pridolfi/mateboard/doc/mateboard.png

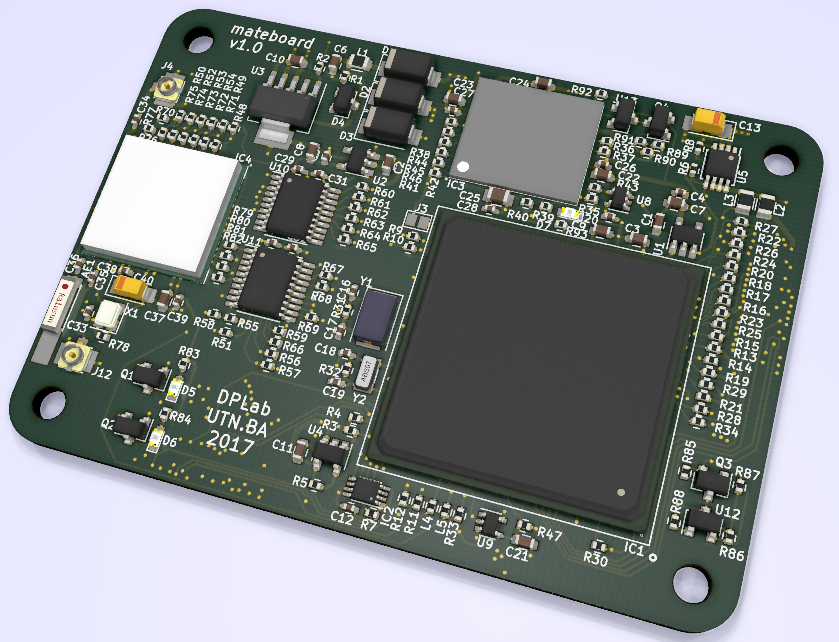
doc/mateboard.png
