pridolfi/mateboard/doc/Mate Presupuesto.ods

Item | qtty | price | shipping | Proveedor
PCB Mate | 3 | 296.00 USD | 40.00 USD | PCB Cart |  | PCB Cart | $5,880.00
Components Mate | 3 | 326.83 USD | 35.00 USD | Mouser |  | Mouser | $8,574.48
PCB Base | 3 | 90.00 USD |  | Meyer |  | Meyer | $1,575.00
Components Base | 3 | 128.14 USD |  | Mouser |  | Assembly | $1,575.00
 |  | 840.97 USD | 75.00 USD | 915.97 USD | $16,029.48
Manufacturing |  | 90.00 USD |  |  | $1,575.00
 |  |  |  |  | $17,604.48
 | 1u$s | $17.50
Averiguar
Montos tope
Facturas con empresas extranjeras ($ o U$s, shipping, etc)
Procedimiento (como pagar, que items deben figurar en la factura, etc)
