pridolfi/mateboard/doc/mateboard.xlsx

 |  |  |  |  |  |  | Board Qty: | 100
 |  |  |  |  |  |  | Total Cost: | $0.00 |  |  |  | $0.00 |  |  |  |  |  | $0.00 |  |  |  |  |  | $0.00 |  |  |  |  |  | $0.00 |  |  |  |  |  | $0.00
 |  |  |  |  |  |  | Unit Cost: | $0.00
Global Part Info |  |  |  |  |  |  |  |  | Digi-Key |  |  |  |  |  | Farnell |  |  |  |  |  | Mouser |  |  |  |  |  | Newark |  |  |  |  |  | Rs Components
Refs | Value | Desc | Footprint | Manf | Manf# | Qty | Unit$ | Ext$ | Avail | Purch | Unit$ | Ext$ | Cat# | Doc | Avail | Purch | Unit$ | Ext$ | Cat# | Doc | Avail | Purch | Unit$ | Ext$ | Cat# | Doc | Avail | Purch | Unit$ | Ext$ | Cat# | Doc | Avail | Purch | Unit$ | Ext$ | Cat# | Doc
R70 | DNP 10k |  | Resistors_SMD:R_0402 |  |  | 0 | $0.00 | $0.00
R3,R4,R58 | 1.5k |  | Resistors_SMD:R_0402 |  | RC0402FR-071K5L | 0 | $0.00 | $0.00 | 1400053 |  | $0.00 | $0.00 | 311-1.50KLRCT-ND | Link (http://www.digikey.com/product-detail/en/yageo/RC0402FR-071K5L/311-1.50KLRCT-ND/729466) |  |  | $0.00 | $0.00 | 9239251 | Link (http://it.farnell.com/yageo-phycomp/rc0402fr-071k5l/res-film-spesso-1k5-1-0-063w-0402/dp/9239251) | 288627 |  | $0.00 | $0.00 | 603-RC0402FR-071K5L | Link (http://www.mouser.com/Search/Refine.aspx?Keyword=RC0402FR-071K5L%20) |  |  | $0.00 | $0.00 | 67R9880 | Link (http://www.newark.com/yageo/rc0402fr-071k5l/res-thick-film-1k5-1-0-0625w-0402/dp/67R9880)
L4,L5 | BLM15AG102SN1D |  | Resistors_SMD:R_0402 |  | BLM15AG102SN1D | 0 | $0.00 | $0.00 | 351484 |  | $0.00 | $0.00 | 490-1007-1-ND | Link (http://www.digikey.com/product-detail/en/murata-electronics-north-america/BLM15AG102SN1D/490-1007-1-ND/584455) |  |  | $0.00 | $0.00 | 1515759RL | Link (http://it.farnell.com/murata/blm15ag102sn1d/grano-chip-1ohm-200ma-0402/dp/1515759RL) | 144423 |  | $0.00 | $0.00 | 81-BLM15AG102SN1D | Link (http://www.mouser.com/Search/Refine.aspx?Keyword=BLM15AG102SN1D%20) |  |  | $0.00 | $0.00 | 73M9022 | Link (http://www.newark.com/webapp/wcs/stores/servlet/Search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) |  |  | $0.00 | $0.00 | 724-1251 | Link (http://it.rs-online.com/web/c/?searchTerm=BLM15AG102SN1D%20)
R56,R57 | 150k |  | Resistors_SMD:R_0402 |  | RC0402FR-07150KL | 0 | $0.00 | $0.00 | 629538 |  | $0.00 | $0.00 | 311-150KLRCT-ND | Link (http://www.digikey.com/product-detail/en/yageo/RC0402FR-07150KL/311-150KLRCT-ND/729489) |  |  | $0.00 | $0.00 | 9239499 | Link (http://it.farnell.com/yageo-phycomp/rc0402fr-07150kl/res-film-spesso-150k-1-0-063w/dp/9239499) | 97865 |  | $0.00 | $0.00 | 603-RC0402FR-07150KL | Link (http://www.mouser.com/Search/Refine.aspx?Keyword=RC0402FR-07150KL%20) |  |  | $0.00 | $0.00 | 12AC2049 | Link (http://www.newark.com/yageo-phycomp/rc0402fr-07150kl/res-thick-film-150k-1-0-063w-0402/dp/12AC2049)
C38 | 1uF/6.3V |  | Capacitors_SMD:C_0402 |  | GRM155R60J105KE19D | 0 | $0.00 | $0.00 |  |  | $0.00 | $0.00 | 490-1320-1-ND | Link (http://www.digikey.com/product-detail/en/murata-electronics-north-america/GRM155R60J105KE19D/490-1320-1-ND/587919) |  |  | $0.00 | $0.00 | 1845729 | Link (http://it.farnell.com/murata/grm155r60j105ke19d/condensatore-mlcc-x5r-1uf-6-3v/dp/1845729) | 292145 |  | $0.00 | $0.00 | 81-GRM155R60J105KE19 | Link (http://www.mouser.com/Search/Refine.aspx?Keyword=GRM155R60J105KE19D%20) |  |  | $0.00 | $0.00 | 13T1188 | Link (http://www.newark.com/murata/grm155r60j105ke19d/multilayer-ceramic-capacitor-grm/dp/13T1188) | 300 |  | $0.00 | $0.00 | 723-5180 | Link (http://it.rs-online.com/web/c/?searchTerm=GRM155R60J105KE19D%20)
AE1 | 2.4GHz Antenna |  | footprints:2450AT43B100E |  | 2450AT42A100E | 0 | $0.00 | $0.00 | 41176 |  | $0.00 | $0.00 | 712-1007-1-ND | Link (http://www.digikey.com/product-detail/en/johanson-technology-inc/2450AT42A100E/712-1007-1-ND/1560836) |  |  | $0.00 | $0.00 | 2148522 | Link (http://it.farnell.com/johanson-technology/2450at42a100e/antenna-2-4ghz/dp/2148522) | 11599 |  | $0.00 | $0.00 | 609-2450AT42A100E | Link (http://www.mouser.com/Search/Refine.aspx?Keyword=2450AT42A100E%20) |  |  | $0.00 | $0.00 | 44W4471 | Link (http://www.newark.com/webapp/wcs/stores/servlet/Search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)
L3 | 0.1ohm 0805 |  | Resistors_SMD:R_0805 |  | 73L3R10J | 0 | $0.00 | $0.00 | 45331 |  | $0.00 | $0.00 | 73L3R10JCT-ND | Link (http://www.digikey.com/product-detail/en/cts-resistor-products/73L3R10J/73L3R10JCT-ND/1543529) |  |  |  |  |  |  | 17765 |  | $0.00 | $0.00 | 774-73L3R10J | Link (http://www.mouser.com/Search/Refine.aspx?Keyword=73L3R10J%20) |  |  | $0.00 | $0.00 | 12AC2373 | Link (http://www.newark.com/cgs-te-connectivity/rl73k2ar10jtd/res-thick-film-r1-5-0-125w-0805/dp/12AC2373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)
X1 | NZ2520SB-32.768KHZ-NSA3534C |  | Crystals:Crystal_SMD_2520-4pin_2.5x2.0mm |  | ASDK2-32.768KHz-LRT | 0 | $0.00 | $0.00 | 6405 |  | $0.00 | $0.00 | 535-13597-1-ND | Link (http://www.digikey.com/product-detail/en/abracon-llc/ASDK2-32.768KHZ-LR-T3/535-13597-1-ND/6167595) |  |  |  |  |  |  | 3364 |  | $0.00 | $0.00 | 815-ASDK2-32.7K-LRT | Link (http://www.mouser.com/Search/../ProductDetail/ABRACON/ASDK2-32768KHz-LRT/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) |  |  | $0.00 | $0.00 | 14T0102 | Link (http://www.newark.com/webapp/wcs/stores/servlet/Search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)
IC4 | WL1835MODGBMOCT |  | footprints:BeagleBone_Blue-GHI-IC_MOC-100(TI) |  | WL1835MODGBMOCR | 0 | $0.00 | $0.00 | 1640 |  | $0.00 | $0.00 | 296-38032-1-ND | Link (http://www.digikey.com/product-detail/en/texas-instruments/WL1835MODGBMOCR/296-38032-1-ND/4965727) |  |  | $0.00 | $0.00 | 2499535 | Link (http://it.farnell.com/webapp/wcs/stores/servlet/Search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) | 780 |  | $0.00 | $0.00 | 595-WL1835MODGBMOCR | Link (http://www.mouser.com/Search/../ProductDetail/Texas-Instruments/WL1835MODGBMOCR/) |  |  | $0.00 | $0.00 | 06X8470 | Link (http://www.newark.com/texas-instruments/wl1835modgbmocr/wilink-wi-fi-2-4ghz-mimo-bt-ble/dp/06X8470)
Q3,Q4 | MMBT2907 |  | TO_SOT_Packages_SMD:SOT-23 |  | MMBT2907ALT1G | 0 | $0.00 | $0.00 | 220280 |  | $0.00 | $0.00 | MMBT2907ALT1GOSCT-ND | Link (http://www.digikey.com/product-detail/en/on-semiconductor/MMBT2907ALT1G/MMBT2907ALT1GOSCT-ND/1139812) |  |  | $0.00 | $0.00 | 1459099 | Link (http://it.farnell.com/on-semiconductor/mmbt2907alt1g/transistor-bjt-pnp-60v-0-6a-sot/dp/1459099) | 183163 |  | $0.00 | $0.00 | 863-MMBT2907ALT1G | Link (http://www.mouser.com/Search/../ProductDetail/ON-Semiconductor/MMBT2907ALT1G/) |  |  | $0.00 | $0.00 | 88H4785 | Link (http://www.newark.com/on-semiconductor/mmbt2907alt1g/bipolar-transistor-pnp-60v-sot/dp/88H4785) | 1400 |  | $0.00 | $0.00 | 781-5231 | Link (http://it.rs-online.com/web/p/transistor-bipolari/7815231/)
R9,R10,R34,R43 | 0R |  | Resistors_SMD:R_0402 |  | RC0402JR-070RL | 0 | $0.00 | $0.00 | 15520665 |  | $0.00 | $0.00 | 311-0.0JRCT-ND | Link (http://www.digikey.com/product-detail/en/yageo/RC0402JR-070RL/311-0.0JRCT-ND/729353) |  |  | $0.00 | $0.00 | 9232516 | Link (http://it.farnell.com/yageo-phycomp/rc0402jr-070rl/res-film-spesso-0r-5-0-0625w-0402/dp/9232516) | 746488 |  | $0.00 | $0.00 | 603-RC0402JR-070RL | Link (http://www.mouser.com/Search/Refine.aspx?Keyword=RC0402JR-070RL%20) |  |  | $0.00 | $0.00 | 66R1737 | Link (http://www.newark.com/yageo/rc0402jr-070rl/res-thick-film-0r-0-0625w-0402/dp/66R1737) | 16 |  | $0.00 | $0.00 | 618-5804 | Link (http://it.rs-online.com/web/c/?searchTerm=RC0402JR-070RL%20)
U3 | TL1963A-33DCQR |  | footprints:SOT-223-6 |  | TL1963A-33DCQR | 0 | $0.00 | $0.00 | 1643 |  | $0.00 | $0.00 | 296-32342-1-ND | Link (http://www.digikey.com/product-detail/en/texas-instruments/TL1963A-33DCQT/296-32342-1-ND/3505532) |  |  |  |  |  |  | 2164 |  | $0.00 | $0.00 | 595-TL1963A-33DCQR | Link (http://www.mouser.com/Search/../ProductDetail/Texas-Instruments/TL1963A-33DCQR/) |  |  | $0.00 | $0.00 | 25R0010 | Link (http://www.newark.com/webapp/wcs/stores/servlet/Search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)
R88,R92 | 40.2k |  | Resistors_SMD:R_0402 |  | RC0402FR-0740K2L | 0 | $0.00 | $0.00 | 628943 |  | $0.00 | $0.00 | 311-40.2KLRCT-ND | Link (http://www.digikey.com/product-detail/en/yageo/RC0402FR-0740K2L/311-40.2KLRCT-ND/729554) |  |  |  |  |  |  | 51381 |  | $0.00 | $0.00 | 603-RC0402FR-0740K2L | Link (http://www.mouser.com/Search/Refine.aspx?Keyword=RC0402FR-0740K2L%20) |  |  | $0.00 | $0.00 | 66R1490 | Link (http://www.newark.com/webapp/wcs/stores/servlet/Search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)
R59,R66 | DNP 1k |  | Resistors_SMD:R_0402 |  |  | 0 | $0.00 | $0.00
R85,R89 | 499 |  | Resistors_SMD:R_0402 |  | RC0402FR-07499RL | 0 | $0.00 | $0.00 | 1290289 |  | $0.00 | $0.00 | 311-499LRCT-ND | Link (http://www.digikey.com/product-detail/en/yageo/RC0402FR-07499RL/311-499LRCT-ND/729570) |  |  | $0.00 | $0.00 | 2413645 | Link (http://it.farnell.com/yageo/rc0402fr-07499rl/res-thick-film-499r-1-0-0625w/dp/2413645) | 219450 |  | $0.00 | $0.00 | 603-RC0402FR-07499RL | Link (http://www.mouser.com/Search/Refine.aspx?Keyword=RC0402FR-07499RL%20) |  |  | $0.00 | $0.00 | 67R9943 | Link (http://www.newark.com/yageo/rc0402fr-07499rl/res-thick-film-499r-1-0-0625w/dp/67R9943)
C16-C19 | 18pF/50V |  | Capacitors_SMD:C_0402 |  | GCM1555C1H180JA16D | 0 | $0.00 | $0.00 | 181585 |  | $0.00 | $0.00 | 490-12650-1-ND | Link (http://www.digikey.com/product-detail/en/murata-electronics-north-america/GCM1555C1H180JA16D/490-12650-1-ND/5797619) |  |  |  |  |  |  | 116284 |  | $0.00 | $0.00 | 81-GCM1555C1H180JA6D | Link (http://www.mouser.com/Search/Refine.aspx?Keyword=GCM1555C1H180JA16D%20)
MH1-MH4 | Mounting hole |  | Mounting_Holes:MountingHole_3.2mm_M3 |  |  | 0 | $0.00 | $0.00
C4,C5,C12,C20,C26-C33,C39 | 100nF/6.3V |  | Capacitors_SMD:C_0402 |  | GRM155R60J104KA01D | 0 | $0.00 | $0.00 | 26123 |  | $0.00 | $0.00 | 490-6287-1-ND | Link (http://www.digikey.com/product-detail/en/murata-electronics-north-america/GRM155R60J104KA01D/490-6287-1-ND/3845484) |  |  |  |  |  |  | 280291 |  | $0.00 | $0.00 | 81-GRM155R60J104KA1D | Link (http://www.mouser.com/Search/../ProductDetail/Murata-Electronics/GRM155R60J104KA01D/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)
C13 | 220uF/6.3V |  | Capacitors_Tantalum_SMD:CP_Tantalum_Case-A_EIA-3216-18_Reflow |  | TAJD227M010RNJ | 0 | $0.00 | $0.00 | 350 |  | $0.00 | $0.00 | 478-3929-1-ND | Link (http://www.digikey.com/product-detail/en/avx-corporation/TAJD227M010RNJ/478-3929-1-ND/1126975) |  |  | $0.00 | $0.00 | 2333073 | Link (http://it.farnell.com/avx/tajd227m010rnj/condensatore-tant-220uf-10v-case/dp/2333073) | 568 |  | $0.00 | $0.00 | 581-TAJD227M010R | Link (http://www.mouser.com/Search/../ProductDetail/AVX/TAJD227M010RNJ/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) |  |  | $0.00 | $0.00 | 70K5250 | Link (http://www.newark.com/avx/tajd227m010rnj/tantalum-capacitor-220uf-10v-0/dp/70K5250)
J19 | VDD_3V3AUX |  | Measurement_Points:Measurement_Point_Round-SMD-Pad_Small |  |  | 0 | $0.00 | $0.00
R2,R78,R83,R84 | 1k |  | Resistors_SMD:R_0402 |  | RC0402FR-071KL | 0 | $0.00 | $0.00 | 17212463 |  | $0.00 | $0.00 | 311-1.00KLRCT-ND | Link (http://www.digikey.com/product-detail/en/yageo/RC0402FR-071KL/311-1.00KLRCT-ND/729460) |  |  | $0.00 | $0.00 | 9239235 | Link (http://it.farnell.com/yageo-phycomp/rc0402fr-071kl/res-film-spesso-1k-1-0-0625w-0402/dp/9239235) | 1570280 |  | $0.00 | $0.00 | 603-RC0402FR-071KL | Link (http://www.mouser.com/Search/Refine.aspx?Keyword=RC0402FR-071KL%20) |  |  | $0.00 | $0.00 | 67R9877 | Link (http://www.newark.com/yageo/rc0402fr-071kl/res-thick-film-1k-1-0-0625w-0402/dp/67R9877)
R51 | DNP 0R |  | Resistors_SMD:R_0402 |  |  | 0 | $0.00 | $0.00
J4,J12 | ANT2 |  | footprints:BeagleBone_Blue-GHI-CONNECTORS_U.FL-R-SMT-1 |  | U.FL-R-SMT-1(10) | 0 | $0.00 | $0.00 | 219950 |  | $0.00 | $0.00 | H11891CT-ND | Link (http://www.digikey.com/product-detail/en/hirose-electric-co-ltd/U.FL-R-SMT-1(10)/H11891CT-ND/2504612) |  |  | $0.00 | $0.00 | 1688077 | Link (http://it.farnell.com/webapp/wcs/stores/servlet/Search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) |  |  | $0.00 | $0.00 | 798-U.FL-R-SMT-110 | Link (http://www.mouser.com/Search/../ProductDetail/Hirose-Connector/UFL-R-SMT-110/) |  |  | $0.00 | $0.00 | 50P8856 | Link (http://www.newark.com/webapp/wcs/stores/servlet/Search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) | 1185 |  | $0.00 | $0.00 | 557-981 | Link (http://it.rs-online.com/web/c/?searchTerm=U.FL-R-SMT-1%2810%29%20)
R7,R13-R28 | 100k |  | Resistors_SMD:R_0402 |  | RC0402FR-07100KL | 0 | $0.00 | $0.00 | 19273058 |  | $0.00 | $0.00 | 311-100KLRCT-ND | Link (http://www.digikey.com/product-detail/en/yageo/RC0402FR-07100KL/311-100KLRCT-ND/729473) |  |  | $0.00 | $0.00 | 9239472 | Link (http://it.farnell.com/yageo-phycomp/rc0402fr-07100kl/res-film-spesso-100k-1-0-063w/dp/9239472) | 1715094 |  | $0.00 | $0.00 | 603-RC0402FR-07100KL | Link (http://www.mouser.com/Search/Refine.aspx?Keyword=RC0402FR-07100KL%20) |  |  | $0.00 | $0.00 | 67R9887 | Link (http://www.newark.com/yageo/rc0402fr-07100kl/res-thick-film-100k-1-0-0625w/dp/67R9887)
U12,U13 | TLVH431 |  | TO_SOT_Packages_SMD:SOT-23 |  | TLVH431IDBZR | 0 | $0.00 | $0.00 | 1496 |  | $0.00 | $0.00 | 296-17974-1-ND | Link (http://www.digikey.com/product-detail/en/texas-instruments/TLVH431IDBZR/296-17974-1-ND/765375) |  |  | $0.00 | $0.00 | 2492382 | Link (http://it.farnell.com/texas-instruments/tlvh431idbzr/voltage-ref-shunt-1-24v-18v-sot/dp/2492382) | 5853 |  | $0.00 | $0.00 | 595-TLVH431IDBZR | Link (http://www.mouser.com/Search/../ProductDetail/Texas-Instruments/TLVH431IDBZR/) |  |  | $0.00 | $0.00 | 54Y8573 | Link (http://www.newark.com/webapp/wcs/stores/servlet/Search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)
J2 | IO2 |  | footprints:DF40C-70DP-0.4V_51_ |  | DF40C-70DP-0.4V(51) | 0 | $0.00 | $0.00 | 9881 |  | $0.00 | $0.00 | H11630CT-ND | Link (http://www.digikey.com/product-detail/en/hirose-electric-co-ltd/DF40C-70DP-0.4V(51)/H11630CT-ND/1969509) |  |  |  |  |  |  | 4027 |  | $0.00 | $0.00 | 798-DF40C70DP04V51 | Link (http://www.mouser.com/Search/Refine.aspx?Keyword=DF40C-70DP-0.4V%2851%29%20)
U10,U11 | TXS0108 |  | Housings_SSOP:TSSOP-20_4.4x6.5mm_Pitch0.65mm |  | TXS0108EPWR | 0 | $0.00 | $0.00 | 78627 |  | $0.00 | $0.00 | 296-23011-1-ND | Link (http://www.digikey.com/product-detail/en/texas-instruments/TXS0108EPWR/296-23011-1-ND/1775304) |  |  | $0.00 | $0.00 | 1702548 | Link (http://it.farnell.com/texas-instruments/txs0108epwr/translator-voltage-8bit-20tssop/dp/1702548) | 14552 |  | $0.00 | $0.00 | 595-TXS0108EPWR | Link (http://www.mouser.com/Search/../ProductDetail/Texas-Instruments/TXS0108EPWR/) |  |  | $0.00 | $0.00 | 73M7866 | Link (http://www.newark.com/texas-instruments/txs0108epwr/no-of-inputs-8/dp/73M7866) | 129 |  | $0.00 | $0.00 | 709-4639 | Link (http://it.rs-online.com/web/p/traslatori-di-tensione/7094639/)
D1-D3 | STPS140A |  | Diodes_SMD:D_SMA_Standard |  | STPS140A | 0 | $0.00 | $0.00 | 13991 |  | $0.00 | $0.00 | 497-2453-1-ND | Link (http://www.digikey.com/product-detail/en/stmicroelectronics/STPS140A/497-2453-1-ND/603835) |  |  | $0.00 | $0.00 | 9907378 | Link (http://it.farnell.com/stmicroelectronics/stps140a/diodo-schottky-1a-40v/dp/9907378) | 11082 |  | $0.00 | $0.00 | 511-STPS140A | Link (http://www.mouser.com/Search/../ProductDetail/STMicroelectronics/STPS140A/) |  |  | $0.00 | $0.00 | 26M3621 | Link (http://www.newark.com/stmicroelectronics/stps140a/rectifier-diode-single-40-v-1/dp/26M3621) | 90 |  | $0.00 | $0.00 | 653-1803 | Link (http://it.rs-online.com/web/p/diodi-rettificatori-e-schottky/6531803/)
U2 | AP2112K-1.8TRG1 |  | TO_SOT_Packages_SMD:TSOT-23-5 |  | AP2112K-1.8TRG1 | 0 | $0.00 | $0.00 | 1204 |  | $0.00 | $0.00 | AP2112K-1.8TRG1DICT-ND | Link (http://www.digikey.com/product-detail/en/diodes-incorporated/AP2112K-1.8TRG1/AP2112K-1.8TRG1DICT-ND/4505256) |  |  |  |  |  |  | 2633 |  | $0.00 | $0.00 | 621-AP2112K-1.8TRG1 | Link (http://www.mouser.com/Search/Refine.aspx?Keyword=AP2112K-1.8TRG1%20) |  |  |  |  |  |  | 2650 |  | $0.00 | $0.00 | 828-3506 | Link (http://it.rs-online.com/web/p/regolatori-di-tensione-low-dropout/8283506/)
D4 | BAT54C |  | TO_SOT_Packages_SMD:SOT-23 |  | BAT54C | 0 | $0.00 | $0.00 |  |  |  |  |  |  |  |  | $0.00 | $0.00 | 2677690 | Link (http://it.farnell.com/taiwan-semiconductor/bat54c/diodo-schottky-30v-0-2a-sot-23/dp/2677690) | 136696 |  | $0.00 | $0.00 | 512-BAT54C | Link (http://www.mouser.com/Search/../ProductDetail/ON-Semiconductor-Fairchild/BAT54C/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) |  |  | $0.00 | $0.00 | 35C0398 | Link (http://www.newark.com/fairchild-semiconductor/bat54c/schottky-rectifier-common-cathode/dp/35C0398) |  |  | $0.00 | $0.00 | 436-7789 | Link (http://it.rs-online.com/web/p/diodi-rettificatori-e-schottky/4367789/)
U4 | 24LC32AT-I |  | TO_SOT_Packages_SMD:SOT-23-5 |  | 24LC32AT-I/OT | 0 | $0.00 | $0.00 | 28372 |  | $0.00 | $0.00 | 24LC32AT-I/OTCT-ND | Link (http://www.digikey.com/product-detail/en/microchip-technology/24LC32AT-I-OT/24LC32AT-I-OTCT-ND/2059983) |  |  | $0.00 | $0.00 | 1700993 | Link (http://it.farnell.com/microchip/24lc32at-i-ot/eeprom-seriale-32kbit-400khz-sot/dp/1700993) | 20352 |  | $0.00 | $0.00 | 579-24LC32AT-I/OT | Link (http://www.mouser.com/Search/Refine.aspx?Keyword=24LC32AT-I%2FOT%20) |  |  | $0.00 | $0.00 | 08P0113 | Link (http://www.newark.com/microchip/24lc32at-i-ot/serial-eeprom-32kbit-400khz-sot/dp/08P0113) |  |  |  |  | 687-8648 | Link (http://it.rs-online.com/web/p/memorie-eeprom/6878648/)
Q1,Q2 | BSS138 |  | TO_SOT_Packages_SMD:SOT-23 |  | BSS138W H6327 | 0 | $0.00 | $0.00 | 42220 |  | $0.00 | $0.00 | BSS138WH6327XTSA1CT-ND | Link (http://www.digikey.com/product-detail/en/infineon-technologies/BSS138WH6327XTSA1/BSS138WH6327XTSA1CT-ND/5410000) |  |  |  |  |  |  | 44446 |  | $0.00 | $0.00 | 726-BSS138WH6327 | Link (http://www.mouser.com/Search/../ProductDetail/Infineon-Technologies/BSS138W-H6327/)
IC1 | OSD335x |  | footprints:OSD3358-BAS-BGA400 |  | OSD3358-512M-BAS | 0 | $0.00 | $0.00 | 179 |  | $0.00 | $0.00 | 1676-1000-ND | Link (http://www.digikey.com/scripts/DkSearch/dksus.dll?WT.z_header=search_go&lang=en) |  |  |  |  |  |  | 932 |  | $0.00 | $0.00 | 415-OSD3358-512M-BAS | Link (http://www.mouser.com/Search/Refine.aspx?Keyword=OSD3358-512M-BAS%20)
J18 | VDD_CORE |  | Measurement_Points:Measurement_Point_Round-SMD-Pad_Small |  |  | 0 | $0.00 | $0.00
R11,R12 | 0 |  | Resistors_SMD:R_0402 |  | RC0402JR-070RL | 0 | $0.00 | $0.00 | 15520665 |  | $0.00 | $0.00 | 311-0.0JRCT-ND | Link (http://www.digikey.com/product-detail/en/yageo/RC0402JR-070RL/311-0.0JRCT-ND/729353) |  |  | $0.00 | $0.00 | 9232516 | Link (http://it.farnell.com/yageo-phycomp/rc0402jr-070rl/res-film-spesso-0r-5-0-0625w-0402/dp/9232516) | 746488 |  | $0.00 | $0.00 | 603-RC0402JR-070RL | Link (http://www.mouser.com/Search/Refine.aspx?Keyword=RC0402JR-070RL%20) |  |  | $0.00 | $0.00 | 66R1737 | Link (http://www.newark.com/yageo/rc0402jr-070rl/res-thick-film-0r-0-0625w-0402/dp/66R1737) | 16 |  | $0.00 | $0.00 | 618-5804 | Link (http://it.rs-online.com/web/c/?searchTerm=RC0402JR-070RL%20)
R29 | 100 |  | Resistors_SMD:R_0402 |  | RC0402FR-07100RL | 0 | $0.00 | $0.00 | 7637483 |  | $0.00 | $0.00 | 311-100LRCT-ND | Link (http://www.digikey.com/product-detail/en/yageo/RC0402FR-07100RL/311-100LRCT-ND/729474) |  |  | $0.00 | $0.00 | 9239111 | Link (http://it.farnell.com/yageo-phycomp/rc0402fr-07100rl/res-film-spesso-100r-1-0-0625w/dp/9239111) | 677189 |  | $0.00 | $0.00 | 603-RC0402FR-07100RL | Link (http://www.mouser.com/Search/Refine.aspx?Keyword=RC0402FR-07100RL%20) |  |  | $0.00 | $0.00 | 67R9888 | Link (http://www.newark.com/yageo/rc0402fr-07100rl/res-thick-film-100r-1-0-0625w/dp/67R9888)
R1,R31 | 1M |  | Resistors_SMD:R_0402 |  | RC0402FR-071ML | 0 | $0.00 | $0.00 | 4237795 |  | $0.00 | $0.00 | 311-1.00MLRCT-ND | Link (http://www.digikey.com/product-detail/en/yageo/RC0402FR-071ML/311-1.00MLRCT-ND/729462) |  |  | $0.00 | $0.00 | 9239588 | Link (http://it.farnell.com/yageo-phycomp/rc0402fr-071ml/res-film-spesso-1m-1-0-063w-0402/dp/9239588) | 276008 |  | $0.00 | $0.00 | 603-RC0402FR-071ML | Link (http://www.mouser.com/Search/Refine.aspx?Keyword=RC0402FR-071ML%20) |  |  | $0.00 | $0.00 | 67R9882 | Link (http://www.newark.com/yageo/rc0402fr-071ml/res-thick-film-1m-1-0-0625w-0402/dp/67R9882) | 3 |  | $0.00 | $0.00 | 618-6194 | Link (http://it.rs-online.com/web/c/?searchTerm=RC0402FR-071ML%20)
IC2 | SN74LVC2G241DCUR |  | Housings_SSOP:VSSOP-8_2.3x2mm_Pitch0.5mm |  | SN74LVC2G241DCUR | 0 | $0.00 | $0.00 | 84097 |  | $0.00 | $0.00 | 296-11936-1-ND | Link (http://www.digikey.com/product-detail/en/texas-instruments/SN74LVC2G241DCUR/296-11936-1-ND/389056) |  |  | $0.00 | $0.00 | 2437234 | Link (http://it.farnell.com/texas-instruments/sn74lvc2g241dcur/doppio-buffer-driver-con-uscita/dp/2437234) | 23908 |  | $0.00 | $0.00 | 595-SN74LVC2G241DCUR | Link (http://www.mouser.com/Search/../ProductDetail/Texas-Instruments/SN74LVC2G241DCUR/) |  |  | $0.00 | $0.00 | 94T5055 | Link (http://www.newark.com/texas-instruments/sn74lvc2g241dcur/non-inverting-buffer-vssop-8/dp/94T5055) | 160 |  | $0.00 | $0.00 | 809-6068 | Link (http://it.rs-online.com/web/c/?searchTerm=SN74LVC2G241DCUR%20)
C34-C36 | 10pF |  | Capacitors_SMD:C_0402 |  | GCM1555C1H100JA16D | 0 | $0.00 | $0.00 | 188590 |  | $0.00 | $0.00 | 490-10668-1-ND | Link (http://www.digikey.com/product-detail/en/murata-electronics-north-america/GCM1555C1H100JA16D/490-10668-1-ND/5251437) |  |  | $0.00 | $0.00 | 2494183 | Link (http://it.farnell.com/murata/gcm1555c1h100ja16d/cond-mlcc-c0g-np0-10pf-50v-0402/dp/2494183) |  |  | $0.00 | $0.00 | 81-GCM1555C1H100JA6D | Link (http://www.mouser.com/Search/Refine.aspx?Keyword=GCM1555C1H100JA16D%20) |  |  | $0.00 | $0.00 | 55Y9822 | Link (http://www.newark.com/webapp/wcs/stores/servlet/Search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)
R33 | 0 1% |  | Resistors_SMD:R_0402 |  | RC0402JR-070RL | 0 | $0.00 | $0.00 | 15520665 |  | $0.00 | $0.00 | 311-0.0JRCT-ND | Link (http://www.digikey.com/product-detail/en/yageo/RC0402JR-070RL/311-0.0JRCT-ND/729353) |  |  | $0.00 | $0.00 | 9232516 | Link (http://it.farnell.com/yageo-phycomp/rc0402jr-070rl/res-film-spesso-0r-5-0-0625w-0402/dp/9232516) | 746488 |  | $0.00 | $0.00 | 603-RC0402JR-070RL | Link (http://www.mouser.com/Search/Refine.aspx?Keyword=RC0402JR-070RL%20) |  |  | $0.00 | $0.00 | 66R1737 | Link (http://www.newark.com/yageo/rc0402jr-070rl/res-thick-film-0r-0-0625w-0402/dp/66R1737) | 16 |  | $0.00 | $0.00 | 618-5804 | Link (http://it.rs-online.com/web/c/?searchTerm=RC0402JR-070RL%20)
L2 | 150ohm 1000mA |  | Resistors_SMD:R_0805 |  | LI0805H151R-10 | 0 | $0.00 | $0.00 | 614929 |  | $0.00 | $0.00 | 240-2384-1-ND | Link (http://www.digikey.com/product-detail/en/laird-signal-integrity-products/LI0805H151R-10/240-2384-1-ND/806744) |  |  | $0.00 | $0.00 | 2292441 | Link (http://it.farnell.com/laird-technologies/li0805h151r-10/ferrite-bead-2012-100mhz-150r/dp/2292441) | 214966 |  | $0.00 | $0.00 | 875-LI0805H151R-10 | Link (http://www.mouser.com/Search/Refine.aspx?Keyword=LI0805H151R-10%20) |  |  | $0.00 | $0.00 | 66W8947 | Link (http://www.newark.com/webapp/wcs/stores/servlet/Search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) |  |  |  |  | 888-3204 | Link (http://it.rs-online.com/web/c/?searchTerm=LI0805H151R-10%20)
J5-J11,J13,J14 | TEST_1P |  | Measurement_Points:Measurement_Point_Round-SMD-Pad_Small |  |  | 0 | $0.00 | $0.00
U9 | 74LVC1G07DCK |  | TO_SOT_Packages_SMD:SOT-353_SC-70-5 |  | SN74LVC1G07DCKR | 0 | $0.00 | $0.00 | 64354 |  | $0.00 | $0.00 | 296-8486-1-ND | Link (http://www.digikey.com/product-detail/en/texas-instruments/SN74LVC1G07DCKR/296-8486-1-ND/377456) |  |  | $0.00 | $0.00 | 1287544 | Link (http://it.farnell.com/texas-instruments/sn74lvc1g07dckr/buffer-driver-single-smd-sc-70/dp/1287544) | 55608 |  | $0.00 | $0.00 | 595-SN74LVC1G07DCKR | Link (http://www.mouser.com/Search/../ProductDetail/Texas-Instruments/SN74LVC1G07DCKR/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) |  |  | $0.00 | $0.00 | 76C4075 | Link (http://www.newark.com/texas-instruments/sn74lvc1g07dckr/non-inverting-buffer-open-drain/dp/76C4075)
C3,C6,C9-C11,C37 | 10uF/6.3V |  | Capacitors_SMD:C_0603 |  | C1608X5R0J106M080AB | 0 | $0.00 | $0.00 | 1839534 |  | $0.00 | $0.00 | 445-4112-1-ND | Link (http://www.digikey.com/product-detail/en/tdk-corporation/C1608X5R0J106M080AB/445-4112-1-ND/1975462) |  |  | $0.00 | $0.00 | 2525086 | Link (http://it.farnell.com/tdk/c1608x5r0j106m080ab/condensatore-mlcc-x5r-10uf-6-3v/dp/2525086) | 390947 |  | $0.00 | $0.00 | 810-C1608X5R0J106M | Link (http://www.mouser.com/Search/Refine.aspx?Keyword=C1608X5R0J106M080AB%20) |  |  | $0.00 | $0.00 | 90R7666 | Link (http://www.newark.com/tdk/c1608x5r0j106m080ab/ceramic-capacitor-10uf-6-3v-x5r/dp/90R7666) | 600 |  | $0.00 | $0.00 | 741-4434 | Link (http://it.rs-online.com/web/p/condensatori-ceramici-multistrato/7414434/)
R55,R60-R65,R67-R69,R71-R77,R79-R82 | 33 |  | Resistors_SMD:R_0402 |  | RC0402JR-0733RL | 0 | $0.00 | $0.00 | 1874106 |  | $0.00 | $0.00 | 311-33JRCT-ND | Link (http://www.digikey.com/product-detail/en/yageo/RC0402JR-0733RL/311-33JRCT-ND/729414) |  |  | $0.00 | $0.00 | 9232583 | Link (http://it.farnell.com/yageo-phycomp/rc0402jr-0733rl/res-film-spesso-33r-5-0-063w-0402/dp/9232583) | 270646 |  | $0.00 | $0.00 | 603-RC0402JR-0733RL | Link (http://www.mouser.com/Search/../ProductDetail/Yageo/RC0402JR-0733RL/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) |  |  | $0.00 | $0.00 | 68R0002 | Link (http://www.newark.com/yageo/rc0402jr-0733rl/res-thick-film-33r-5-0-0625w-0402/dp/68R0002)
R86,R90 | DNP |  | Resistors_SMD:R_0402 |  |  | 0 | $0.00 | $0.00
Y1 | 24MHz |  | Crystals:Crystal_SMD_5032-2pin_5.0x3.2mm |  | 7A-24.000MAAJ-T | 0 | $0.00 | $0.00 | 102530 |  | $0.00 | $0.00 | 887-1090-1-ND | Link (http://www.digikey.com/product-detail/en/txc-corporation/7A-24.000MAAJ-T/887-1090-1-ND/2118967) |  |  | $0.00 | $0.00 | 1841952 | Link (http://it.farnell.com/txc/7a-24-000maaj-t/xtal-24-000mhz-18pf-smd-5-0x3/dp/1841952) | 14256 |  | $0.00 | $0.00 | 717-7A-24.000MAAJ-T | Link (http://www.mouser.com/Search/Refine.aspx?Keyword=7A-24.000MAAJ-T%20) |  |  | $0.00 | $0.00 | 84R5657 | Link (http://www.newark.com/txc/7a-24-000maaj-t/crystal-24mhz-18pf-5-x-3-2mm/dp/84R5657)
J16 | VDDS_DDR |  | Measurement_Points:Measurement_Point_Round-SMD-Pad_Small |  |  | 0 | $0.00 | $0.00
C1,C2,C7,C8,C21-C24 | 2.2uF/6.3V |  | Capacitors_SMD:C_0603 |  | GCM188R70J225KE22D | 0 | $0.00 | $0.00 | 201916 |  | $0.00 | $0.00 | 490-5316-1-ND | Link (http://www.digikey.com/product-detail/en/murata-electronics-north-america/GCM188R70J225KE22D/490-5316-1-ND/2039095) |  |  | $0.00 | $0.00 | 2470422 | Link (http://it.farnell.com/murata/gcm188r70j225ke22d/condensat-mlcc-x7r-2-2uf-6-3v/dp/2470422) | 670440 |  | $0.00 | $0.00 | 81-GCM188R70J225KE2D | Link (http://www.mouser.com/Search/Refine.aspx?Keyword=GCM188R70J225KE22D%20) |  |  | $0.00 | $0.00 | 45Y5161 | Link (http://www.newark.com/murata/gcm188r70j225ke22d/multilayer-ceramic-capacitor-aec/dp/45Y5161) | 150 |  | $0.00 | $0.00 | 815-1272 | Link (http://it.rs-online.com/web/c/?searchTerm=GCM188R70J225KE22D%20)
C40 | DNP 47uF |  | Capacitors_Tantalum_SMD:CP_Tantalum_Case-A_EIA-3216-18_Reflow |  |  | 0 | $0.00 | $0.00
C25 | 4.7uF/6.3V |  | Capacitors_SMD:C_0805 |  | 08056D475KAT2A | 0 | $0.00 | $0.00 | 11921 |  | $0.00 | $0.00 | 478-1416-1-ND | Link (http://www.digikey.com/product-detail/en/avx-corporation/08056D475KAT2A/478-1416-1-ND/564448) |  |  | $0.00 | $0.00 | 1833810 | Link (http://it.farnell.com/avx/08056d475kat2a/condens-mlcc-x5r-4-7uf-6-3v-0805/dp/1833810) | 17962 |  | $0.00 | $0.00 | 581-08056D475K | Link (http://www.mouser.com/Search/Refine.aspx?Keyword=08056D475KAT2A%20) |  |  | $0.00 | $0.00 | 84K8400 | Link (http://www.newark.com/avx/08056d475kat2a/ceramic-capacitor-4-7uf-6-3v-x5r/dp/84K8400) | 2750 |  | $0.00 | $0.00 | 391-173 | Link (http://it.rs-online.com/web/p/condensatori-ceramici-multistrato/0391173/)
U1 | AP2112K-3.3TRG1 |  | TO_SOT_Packages_SMD:TSOT-23-5 |  | AP2112K-3.3TRG1 | 0 | $0.00 | $0.00 | 55653 |  | $0.00 | $0.00 | AP2112K-3.3TRG1DICT-ND | Link (http://www.digikey.com/product-detail/en/diodes-incorporated/AP2112K-3.3TRG1/AP2112K-3.3TRG1DICT-ND/4505257) |  |  |  |  |  |  | 20110 |  | $0.00 | $0.00 | 621-AP2112K-3.3TRG1 | Link (http://www.mouser.com/Search/Refine.aspx?Keyword=AP2112K-3.3TRG1%20) |  |  |  |  |  |  | 8400 |  | $0.00 | $0.00 | 828-3509 | Link (http://it.rs-online.com/web/p/regolatori-di-tensione-low-dropout/8283509/)
U8 | SN74LVC1G06DCK |  | TO_SOT_Packages_SMD:SOT-353_SC-70-5 |  | SN74LVC1G06DCKR | 0 | $0.00 | $0.00 | 24402 |  | $0.00 | $0.00 | 296-8484-1-ND | Link (http://www.digikey.com/product-detail/en/texas-instruments/SN74LVC1G06DCKR/296-8484-1-ND/377453) |  |  | $0.00 | $0.00 | 2437123 | Link (http://it.farnell.com/texas-instruments/sn74lvc1g06dckr/invertitore-c-open-drain-singolo/dp/2437123) | 11842 |  | $0.00 | $0.00 | 595-SN74LVC1G06DCKR | Link (http://www.mouser.com/Search/../ProductDetail/Texas-Instruments/SN74LVC1G06DCKR/) |  |  | $0.00 | $0.00 | 76C4074 | Link (http://www.newark.com/texas-instruments/sn74lvc1g06dckr/logic-single-inverter-buff-driver/dp/76C4074) |  |  |  |  | 662-8691 | Link (http://it.rs-online.com/web/p/driver-di-linea-e-buffer/6628691/)
D5-D7 | LTST-C191TBKT |  | LEDs:LED_0603 |  | LTST-C191TBKT-5A | 0 | $0.00 | $0.00 |  |  | $0.00 | $0.00 | LTST-C191TBKT-5A-ND | Link (http://www.digikey.com/scripts/DkSearch/dksus.dll?WT.z_header=search_go&lang=en) |  |  |  |  |  |  | 1519 |  | $0.00 | $0.00 | 859-LTST-C191TBKT-5A | Link (http://www.mouser.com/Search/Refine.aspx?Keyword=LTST-C191TBKT-5A%20)
IC3 | NAND_4GB |  | footprints:BeagleBone_Blue-GHI-IC_MICRON_EMMC_153_MODIFICADO |  | SDIN8DE2-4G-I | 0 | $0.00 | $0.00 |  |  |  |  |  |  |  |  |  |  |  |  |  |  | $0.00 | $0.00 | 467-SDIN8DE2-4G-I | Link (http://www.mouser.com/Search/Refine.aspx?Keyword=SDIN8DE2-4G-I%20)
Y2 | 32.768kHz |  | Crystals:Crystal_SMD_3215-2pin_3.2x1.5mm |  | ABS07-32.768KHZ-7-T | 0 | $0.00 | $0.00 | 81815 |  | $0.00 | $0.00 | 535-9543-1-ND | Link (http://www.digikey.com/product-detail/en/abracon-llc/ABS07-32.768KHZ-7-T/535-9543-1-ND/1237010) |  |  | $0.00 | $0.00 | 1838935 | Link (http://it.farnell.com/abracon/abs07-32-768khz-7-t/cristallo-32-768khz-7pf-smd/dp/1838935) | 45306 |  | $0.00 | $0.00 | 815-ABS07-32.768K7T | Link (http://www.mouser.com/Search/Refine.aspx?Keyword=ABS07-32.768KHZ-7-T%20) |  |  | $0.00 | $0.00 | 14N8750 | Link (http://www.newark.com/abracon/abs07-32-768khz-7-t/crystal-32-768khz-7pf-3-2-x-1/dp/14N8750)
L1 | BLM21AG221SN1D |  | Resistors_SMD:R_0805 |  | BLM21AG221SN1D | 0 | $0.00 | $0.00 | 9912 |  | $0.00 | $0.00 | 490-9704-1-ND | Link (http://www.digikey.com/product-detail/en/murata-electronics-north-america/BLM21AG221SN1D/490-9704-1-ND/4934847) |  |  | $0.00 | $0.00 | 1515619 | Link (http://it.farnell.com/murata/blm21ag221sn1d/grano-chip-0-13ohm-800ma-0805/dp/1515619) | 5288 |  | $0.00 | $0.00 | 81-BLM21AG221SN1D | Link (http://www.mouser.com/Search/Refine.aspx?Keyword=BLM21AG221SN1D%20) |  |  | $0.00 | $0.00 | 73M9130 | Link (http://www.newark.com/webapp/wcs/stores/servlet/Search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) | 275 |  | $0.00 | $0.00 | 724-1488 | Link (http://it.rs-online.com/web/c/?searchTerm=BLM21AG221SN1D%20)
R93 | 4.75k |  | Resistors_SMD:R_0402 |  | RC0402FR-074K75L | 0 | $0.00 | $0.00 | 1197803 |  | $0.00 | $0.00 | 311-4.75KLCT-ND | Link (http://www.digikey.com/product-detail/en/yageo/RC0402FR-074K75L/311-4.75KLCT-ND/2827885) |  |  | $0.00 | $0.00 | 1799212 | Link (http://it.farnell.com/webapp/wcs/stores/servlet/Search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) | 4576 |  | $0.00 | $0.00 | 603-RC0402FR-074K75L | Link (http://www.mouser.com/Search/../ProductDetail/Yageo/RC0402FR-074K75L/) |  |  | $0.00 | $0.00 | 67R9934 | Link (http://www.newark.com/webapp/wcs/stores/servlet/Search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)
U5 | TPS2065CDGN |  | Housings_SSOP:MSOP-8-1EP_3x3mm_Pitch0.65mm |  | TPS2065CDGNR | 0 | $0.00 | $0.00 | 2919 |  | $0.00 | $0.00 | 296-29508-5-ND | Link (http://www.digikey.com/product-detail/en/texas-instruments/TPS2065CDGN/296-29508-5-ND/2751271) |  |  |  |  |  |  | 2362 |  | $0.00 | $0.00 | 595-TPS2065CDGNR | Link (http://www.mouser.com/Search/../ProductDetail/Texas-Instruments/TPS2065CDGNR/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) |  |  | $0.00 | $0.00 | 61T6040 | Link (http://www.newark.com/texas-instruments/tps2065cdgnr/current-limited-power-distribution/dp/61T6040)
R30 | 10k 1% |  | Resistors_SMD:R_0402 |  | RC0402FR-0710KL | 0 | $0.00 | $0.00 | 17165201 |  | $0.00 | $0.00 | 311-10.0KLRCT-ND | Link (http://www.digikey.com/product-detail/en/yageo/RC0402FR-0710KL/311-10.0KLRCT-ND/729470) |  |  | $0.00 | $0.00 | 2363463 | Link (http://it.farnell.com/yageo/rc0402fr-0710kl/res-thick-film-10k-1-0-0625w-0402/dp/2363463) | 2145434 |  | $0.00 | $0.00 | 603-RC0402FR-0710KL | Link (http://www.mouser.com/Search/Refine.aspx?Keyword=RC0402FR-0710KL%20) |  |  | $0.00 | $0.00 | 67R9884 | Link (http://www.newark.com/yageo/rc0402fr-0710kl/res-thick-film-10k-1-0-0625w-0402/dp/67R9884)
J15 | VDDS_PLL |  | Measurement_Points:Measurement_Point_Round-SMD-Pad_Small |  |  | 0 | $0.00 | $0.00
J17 | VDD_MPU |  | Measurement_Points:Measurement_Point_Round-SMD-Pad_Small |  |  | 0 | $0.00 | $0.00
J3 | GS2 |  | Connectors:GS2 |  |  | 0 | $0.00 | $0.00
R5,R6,R8,R35-R42,R44-R50,R52-R54,R87,R91 | 10k |  | Resistors_SMD:R_0402 |  | RC0402FR-0710KL | 0 | $0.00 | $0.00 | 17165201 |  | $0.00 | $0.00 | 311-10.0KLRCT-ND | Link (http://www.digikey.com/product-detail/en/yageo/RC0402FR-0710KL/311-10.0KLRCT-ND/729470) |  |  | $0.00 | $0.00 | 2363463 | Link (http://it.farnell.com/yageo/rc0402fr-0710kl/res-thick-film-10k-1-0-0625w-0402/dp/2363463) | 2145434 |  | $0.00 | $0.00 | 603-RC0402FR-0710KL | Link (http://www.mouser.com/Search/Refine.aspx?Keyword=RC0402FR-0710KL%20) |  |  | $0.00 | $0.00 | 67R9884 | Link (http://www.newark.com/yageo/rc0402fr-0710kl/res-thick-film-10k-1-0-0625w-0402/dp/67R9884)
J20 | VDD_RTC |  | Measurement_Points:Measurement_Point_Round-SMD-Pad_Small |  |  | 0 | $0.00 | $0.00
J1 | IO1 |  | footprints:DF40C-70DP-0.4V_51_ |  | DF40C-70DP-0.4V(51) | 0 | $0.00 | $0.00 | 9881 |  | $0.00 | $0.00 | H11630CT-ND | Link (http://www.digikey.com/product-detail/en/hirose-electric-co-ltd/DF40C-70DP-0.4V(51)/H11630CT-ND/1969509) |  |  |  |  |  |  | 4027 |  | $0.00 | $0.00 | 798-DF40C70DP04V51 | Link (http://www.mouser.com/Search/Refine.aspx?Keyword=DF40C-70DP-0.4V%2851%29%20)
R32 | DNP 1M |  | Resistors_SMD:R_0402 |  |  | 0 | $0.00 | $0.00
 |  |  |  |  |  |  |  |  |  | 0 | 0 | 0 |  |  |  | 0 | 0 | 0 |  |  |  | 0 | 0 | 0 |  |  |  | 0 | 0 | 0 |  |  |  | 0 | 0 | 0
 |  |  |  |  |  |  |  |  |  | 0 | 0 | 0 |  |  |  | 0 | 0 | 0 |  |  |  | 0 | 0 | 0 |  |  |  | 0 | 0 | 0 |  |  |  | 0 | 0 | 0
 |  |  |  |  |  |  |  |  |  | 0 | 0 | 0 |  |  |  | 0 | 0 | 0 |  |  |  | 0 | 0 | 0 |  |  |  | 0 | 0 | 0 |  |  |  | 0 | 0 | 0
 |  |  |  |  |  |  |  |  |  | 0 | 0 | 0 |  |  |  | 0 | 0 | 0 |  |  |  | 0 | 0 | 0 |  |  |  | 0 | 0 | 0 |  |  |  | 0 | 0 | 0
 |  |  |  |  |  |  |  |  |  | 0 | 0 | 0 |  |  |  | 0 | 0 | 0 |  |  |  | 0 | 0 | 0 |  |  |  | 0 | 0 | 0 |  |  |  | 0 | 0 | 0
 |  |  |  |  |  |  |  |  |  | 0 | 0 | 0 |  |  |  | 0 | 0 | 0 |  |  |  | 0 | 0 | 0 |  |  |  | 0 | 0 | 0 |  |  |  | 0 | 0 | 0
 |  |  |  |  |  |  |  |  |  | 0 | 0 | 0 |  |  |  | 0 | 0 | 0 |  |  |  | 0 | 0 | 0 |  |  |  | 0 | 0 | 0 |  |  |  | 0 | 0 | 0
 |  |  |  |  |  |  |  |  |  | 0 | 0 | 0 |  |  |  | 0 | 0 | 0 |  |  |  | 0 | 0 | 0 |  |  |  | 0 | 0 | 0 |  |  |  | 0 | 0 | 0
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
 |  |  |  |  |  |  |  |  |  | 0 | 0 | 0 |  |  |  | 0 | 0 | 0 |  |  |  | 0 | 0 | 0 |  |  |  | 0 | 0 | 0 |  |  |  | 0 | 0 | 0
 |  |  |  |  |  |  |  |  |  | 0 | 0 | 0 |  |  |  | 0 | 0 | 0 |  |  |  | 0 | 0 | 0 |  |  |  | 0 | 0 | 0 |  |  |  | 0 | 0 | 0
