pridolfi/mateboard/3dmodel/User Library-AN9520.STEP

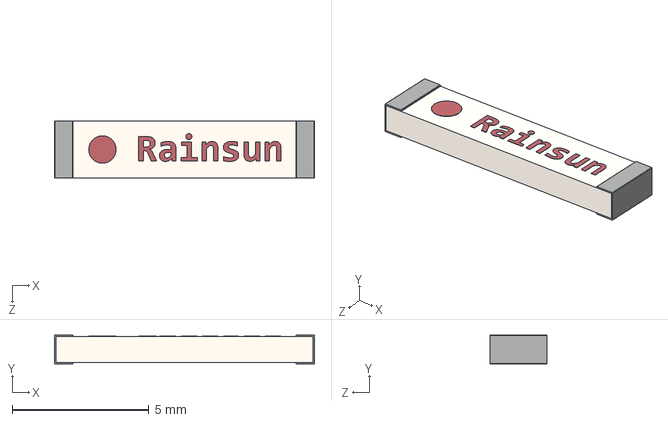
[picture p2: CAD file, 2017-06-29]
3dmodel/User Library-AN9520.STEP
9.50 x 1.05 x 2.10 mm
