pridolfi/mateboard/3dmodel/ABS07.STEP

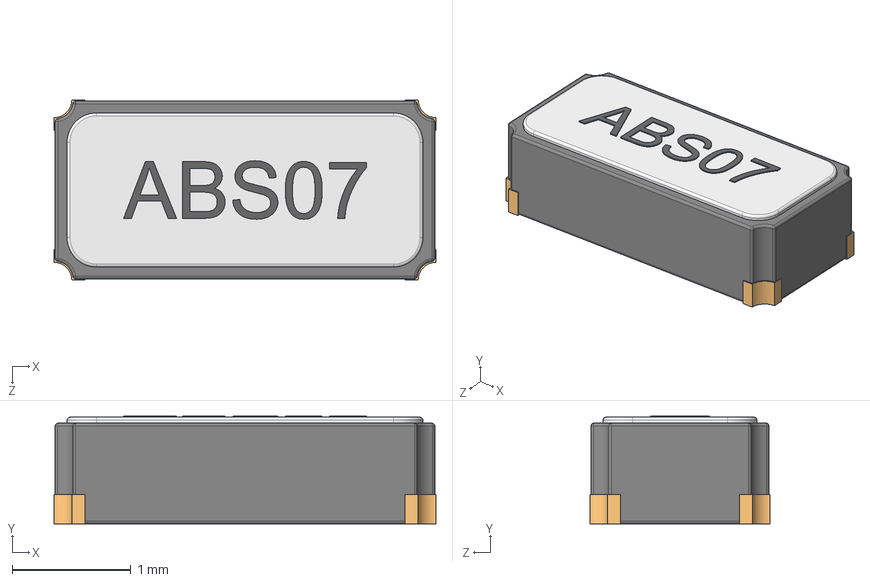
[picture p3: CAD file, 2017-06-29]
3dmodel/ABS07.STEP
3.22 x 0.91 x 1.52 mm
User Library-ABS07_ABS07 Body_2
User Library-ABS07_ABS07 Body2_2
User Library-ABS07_ABS07 Beschriftung_2
User Library-ABS07_ABS07 Pads_2
