pridolfi/mateboard/3dmodel/WL18xx.STEP

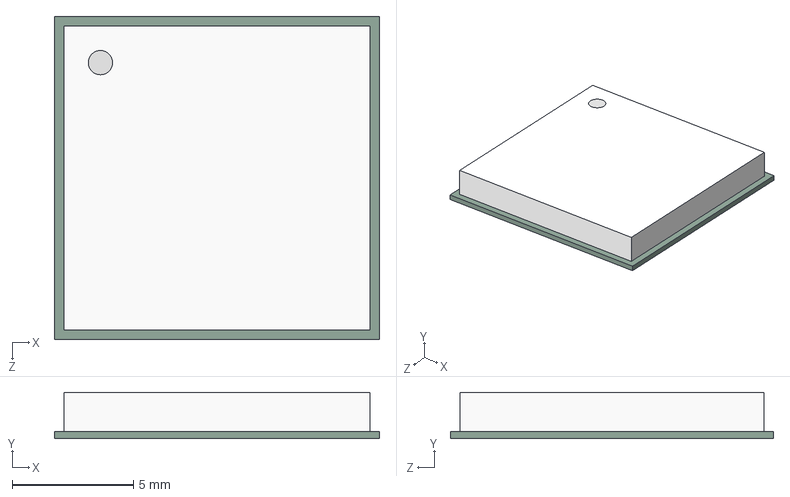
[picture p4: CAD file, 2017-06-29]
3dmodel/WL18xx.STEP
13.4 x 1.90 x 13.3 mm
