pridolfi/mateboard/3dmodel/User Library-153BallWFBGA.STEP

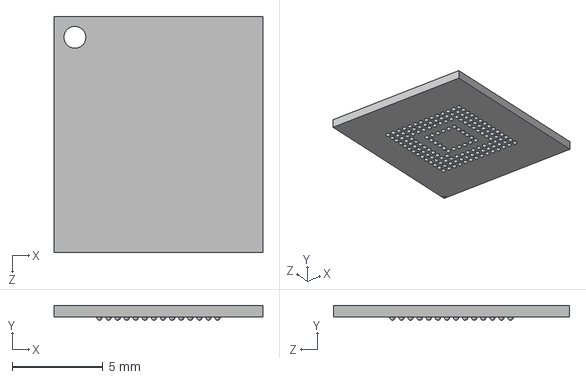
[picture p5: CAD file, 2017-06-29]
3dmodel/User Library-153BallWFBGA.STEP
11.5 x 0.802 x 13.0 mm
