pridolfi/mateboard/3dmodel/SOT-223_5MC.stp

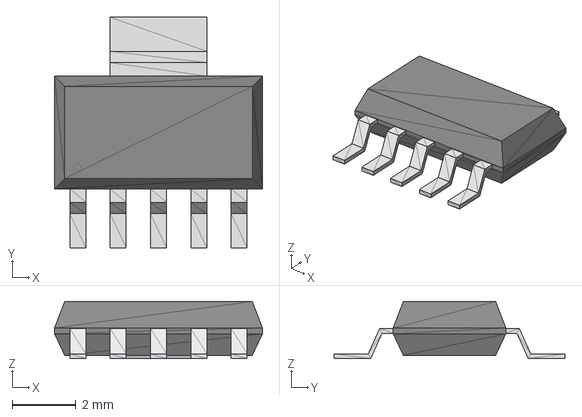
[picture p6: CAD file, 2017-06-21]
3dmodel/SOT-223_5MC.stp
6.55 x 7.26 x 1.80 mm
