pridolfi/mateboard/3dmodel/DF40C-70DP.stp

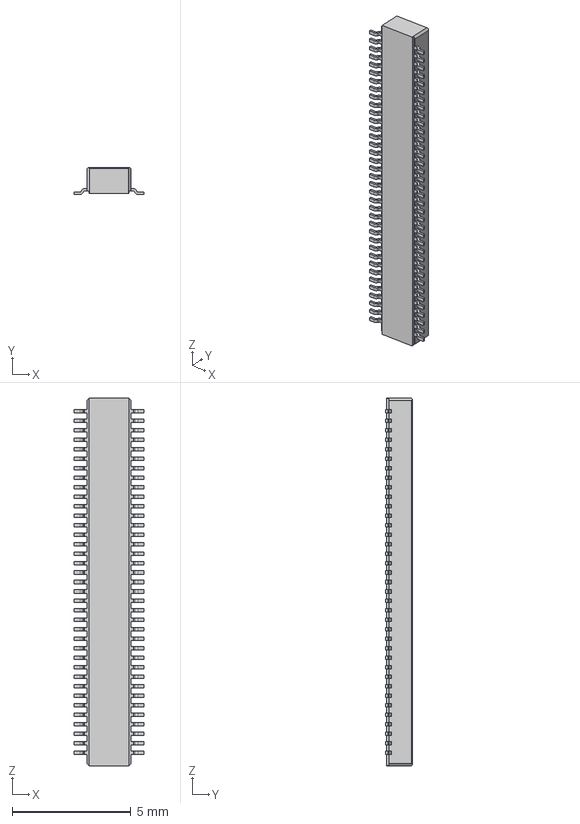
[picture p7: CAD file, 2017-06-21]
3dmodel/DF40C-70DP.stp
2.97 x 1.14 x 15.5 mm
