pridolfi/mateboard/3dmodel/U.FL-R-SMT-1.stp

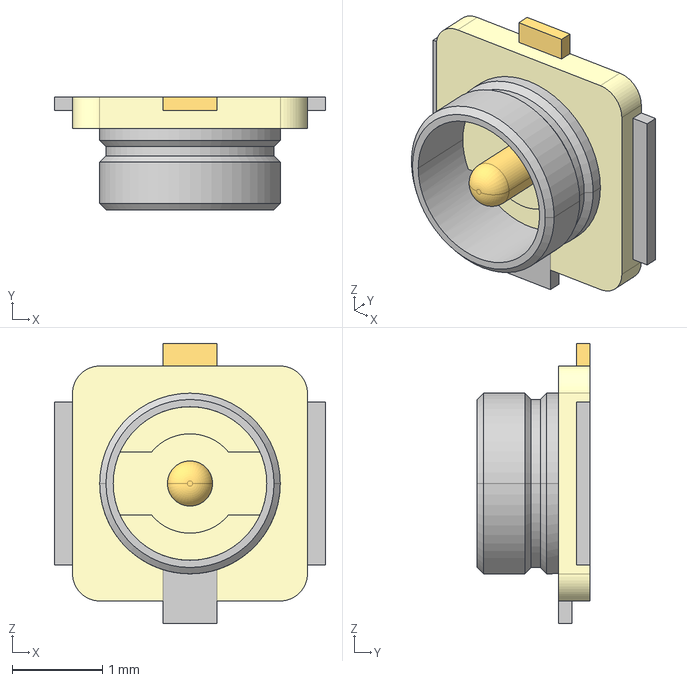
[picture p8: CAD file, 2017-06-21]
3dmodel/U.FL-R-SMT-1.stp
3.00 x 1.25 x 3.10 mm
