pridolfi/mateboard/doc/mateboard.pdf

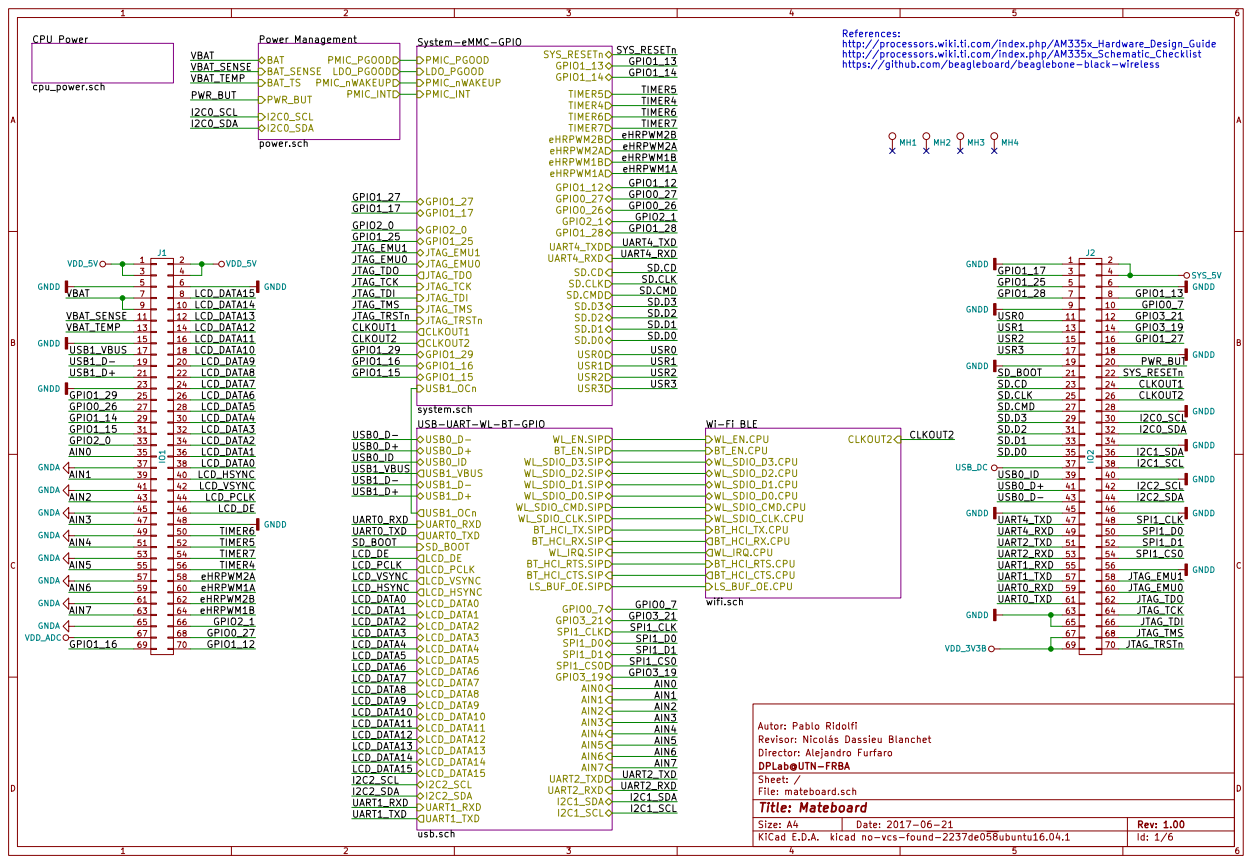
[picture p9: page 1]

https://github.com/beagleboard/beaglebone-black-wireless VBAT VBAT_SENSE

http://processors.wiki.ti.com/index.php/AM335x_Schematic_Checklist

LCD_DATA5
LCD_DATA6
LCD_DATA7
LCD_DATA8
LCD_DATA9
LCD_DATA10
LCD_DATA11
LCD_DATA12
LCD_DATA13
LCD_DATA14
LCD_DATA15

Director: Alejandro Furfaro Revisor: Nicolás Dassieu Blanchet Autor: Pablo Ridolfi

File: mateboard.sch Sheet: / DPLab@UTN-FRBA

UART2_TXD

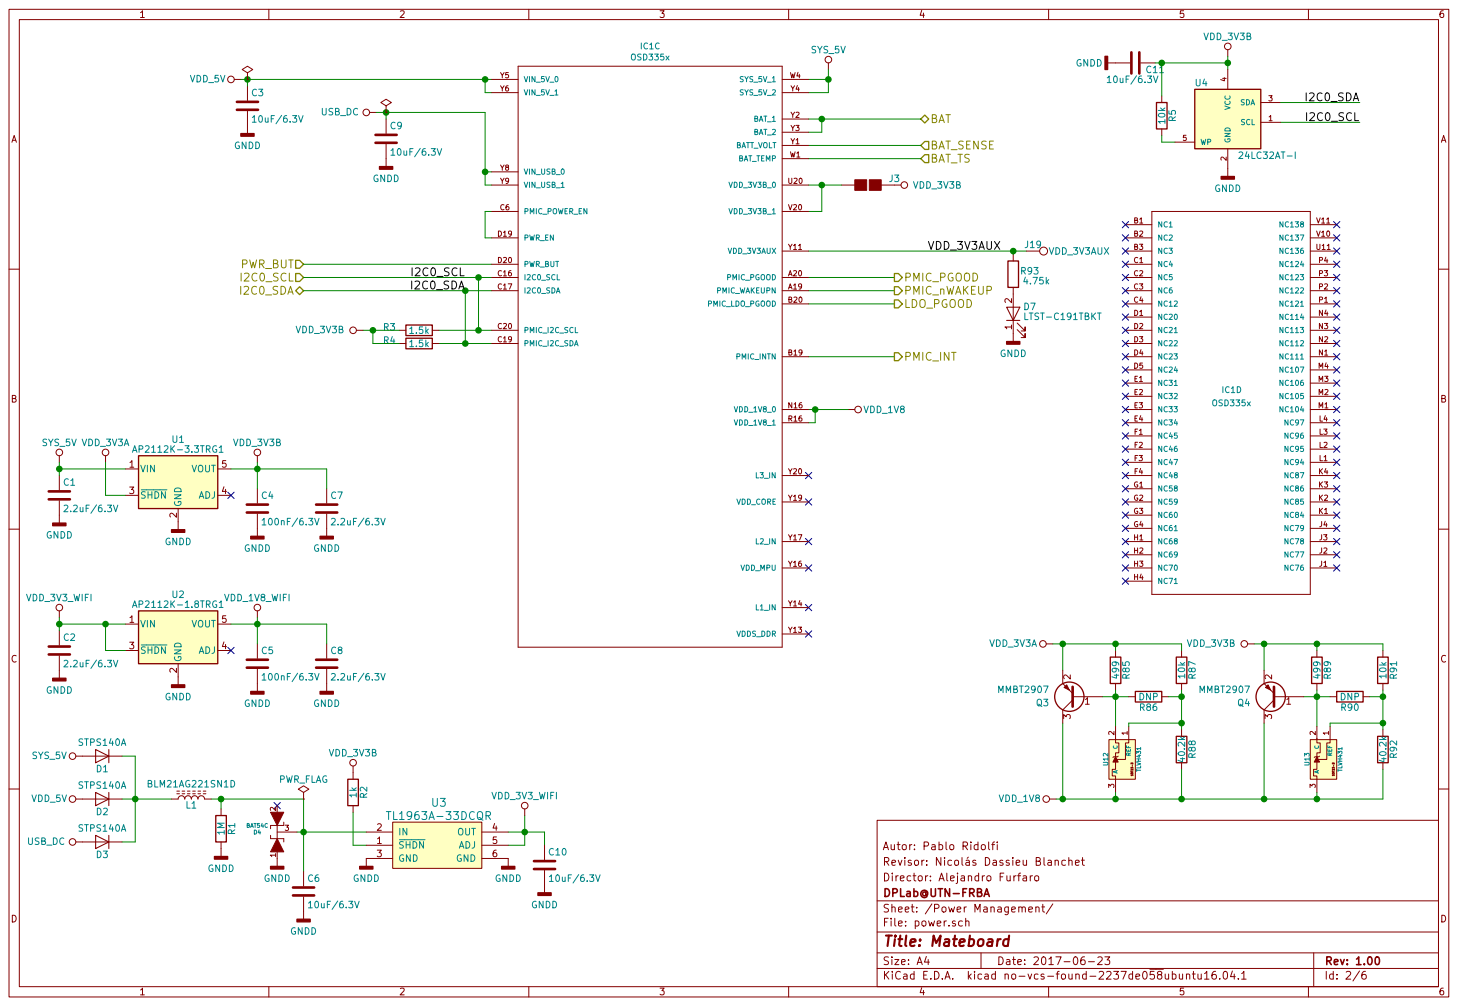
[picture p10: page 2]

I2C0_SCL

I2C0_SDA C17

Director: Alejandro Furfaro Revisor: Nicolás Dassieu Blanchet Autor: Pablo Ridolfi

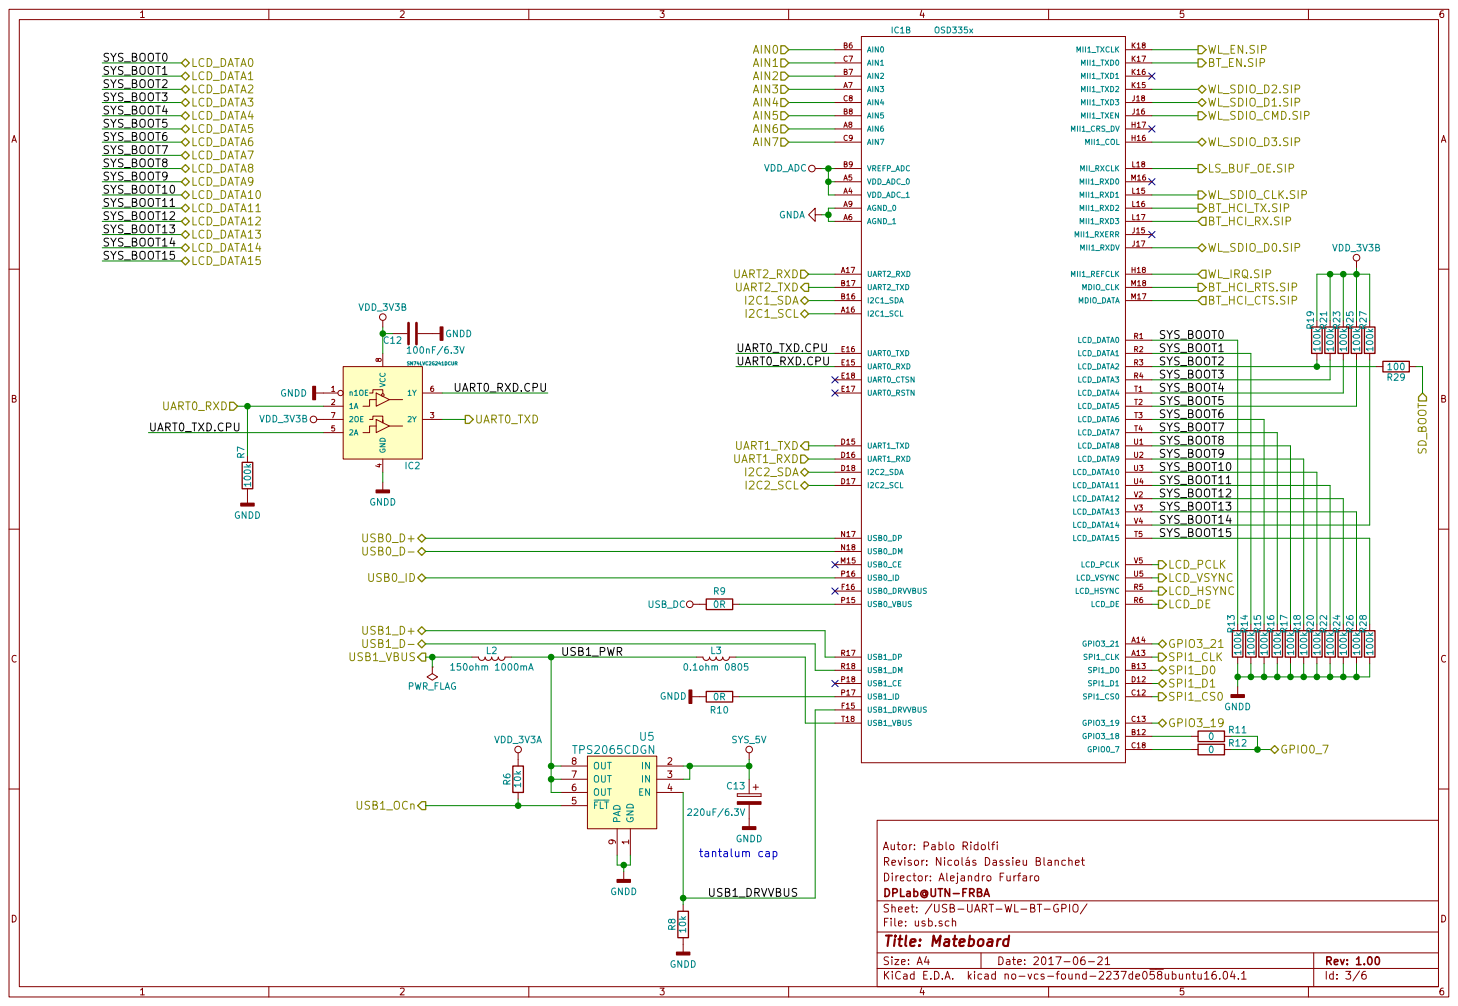
[picture p11: page 3]

SYS_BOOT4
SYS_BOOT5

SYS_BOOT7
SYS_BOOT8
SYS_BOOT9
SYS_BOOT10
SYS_BOOT11
SYS_BOOT12
SYS_BOOT13
SYS_BOOT14

Director: Alejandro Furfaro Revisor: Nicolás Dassieu Blanchet Autor: Pablo Ridolfi USB0_D+
USB0_D-

File: usb.sch Sheet: /USB-UART-WL-BT-GPIO/ DPLab@UTN-FRBA

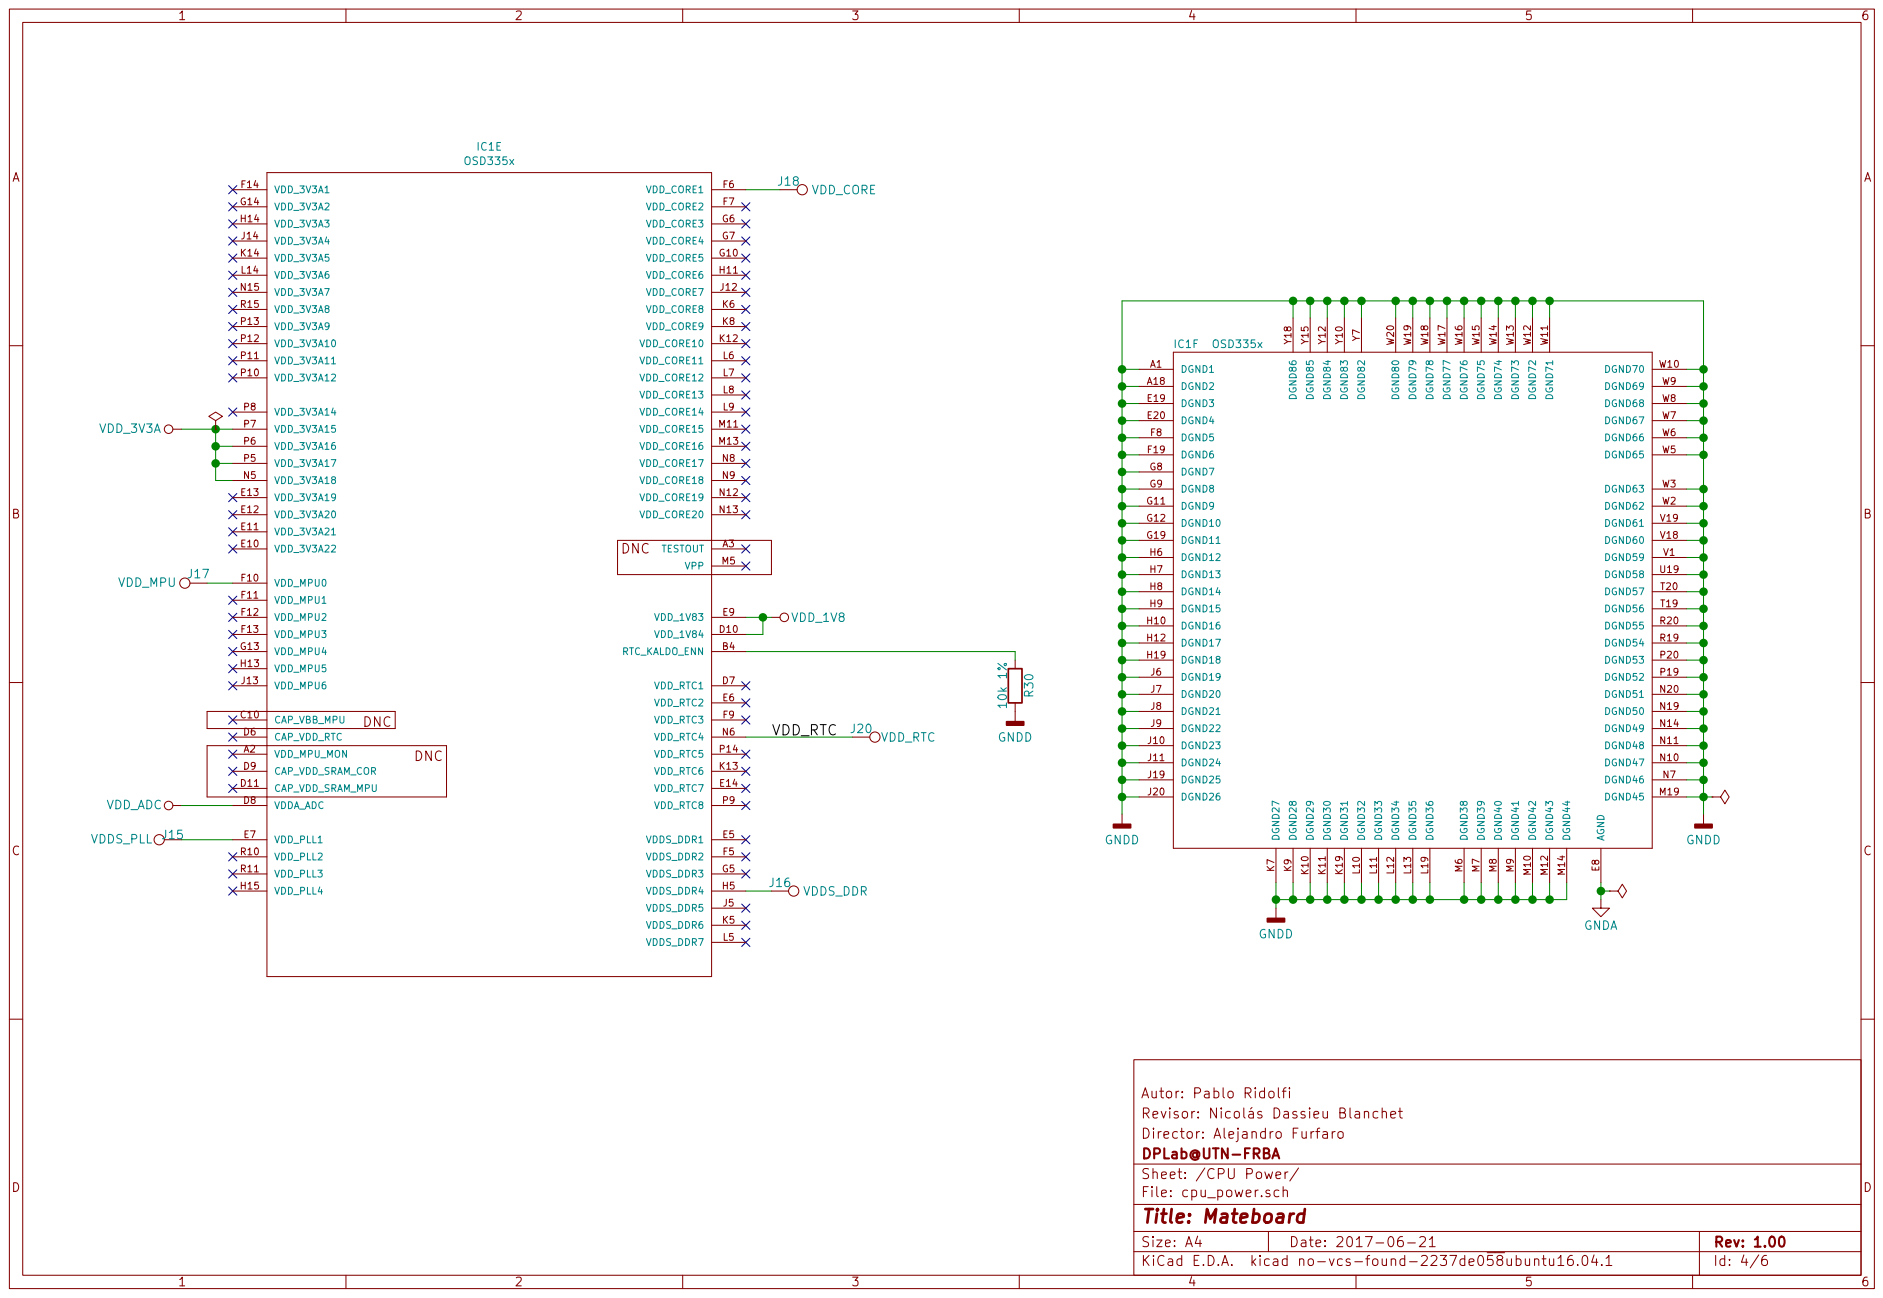
[picture p12: page 4]

File: cpu_power.sch Sheet: /CPU Power/ DPLab@UTN-FRBA

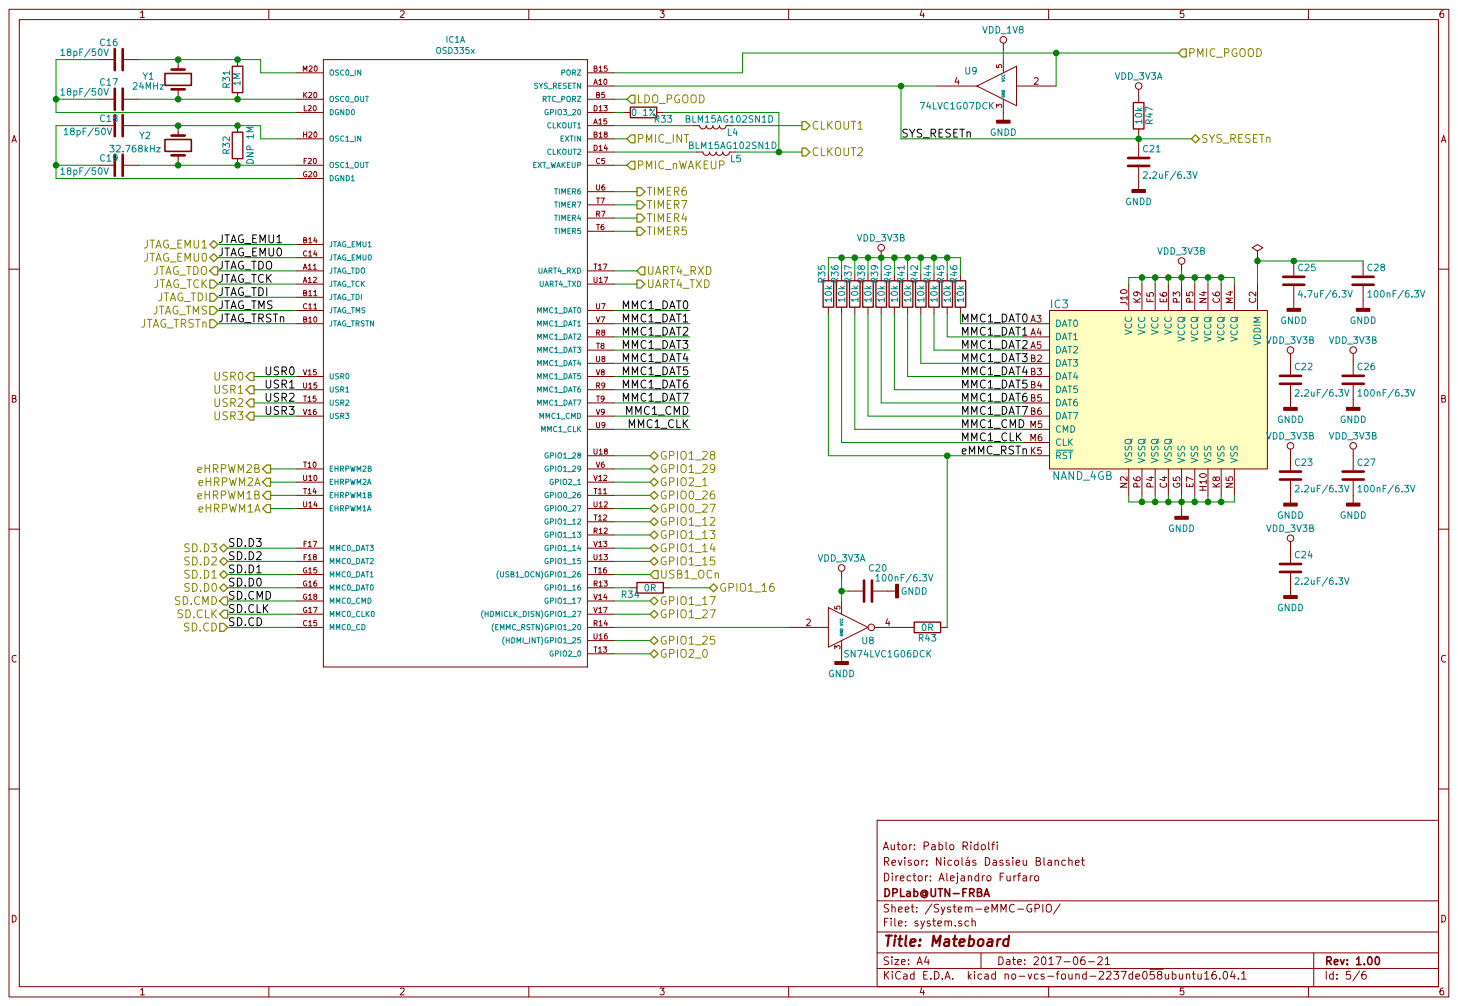
[picture p13: page 5]

Director: Alejandro Furfaro Revisor: Nicolás Dassieu Blanchet Autor: Pablo Ridolfi

DPLab@UTN-FRBA
Sheet: /System-eMMC-GPIO/
File: system.sch
Id: 5/6 Title: Mateboard

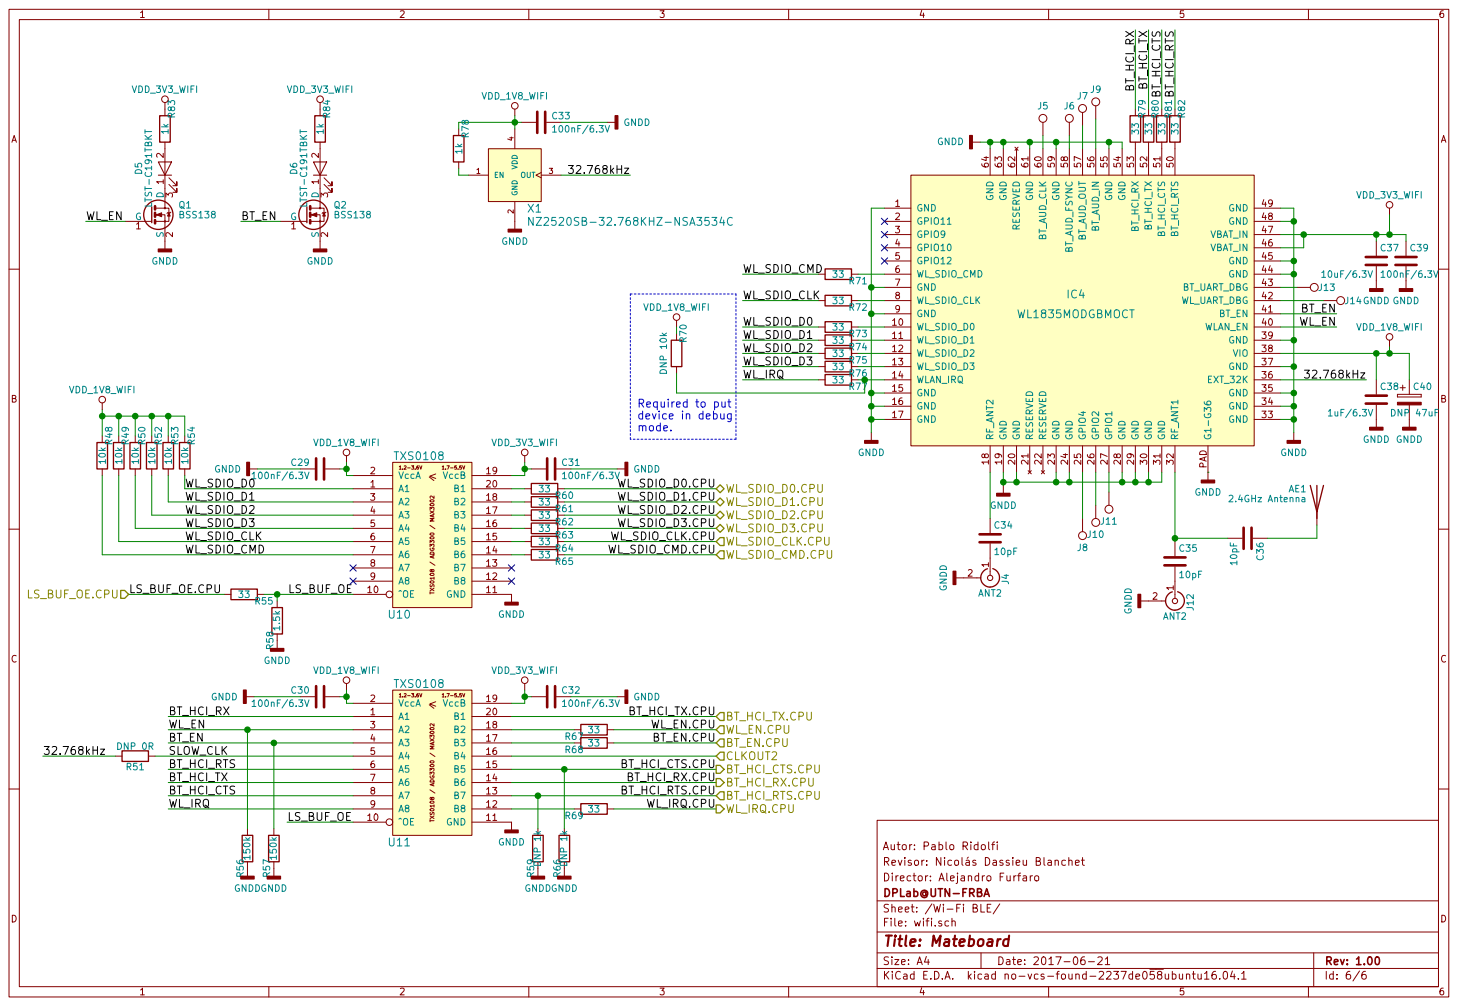
[picture p14: page 6]

Director: Alejandro Furfaro Revisor: Nicolás Dassieu Blanchet Autor: Pablo Ridolfi LS_BUF_OE

File: wifi.sch Sheet: /Wi-Fi BLE/ DPLab@UTN-FRBA
