pridolfi/mateboard/mateboard.kicad_pcb

## KiCad design mateboard.kicad_pcb (2017-07-24)

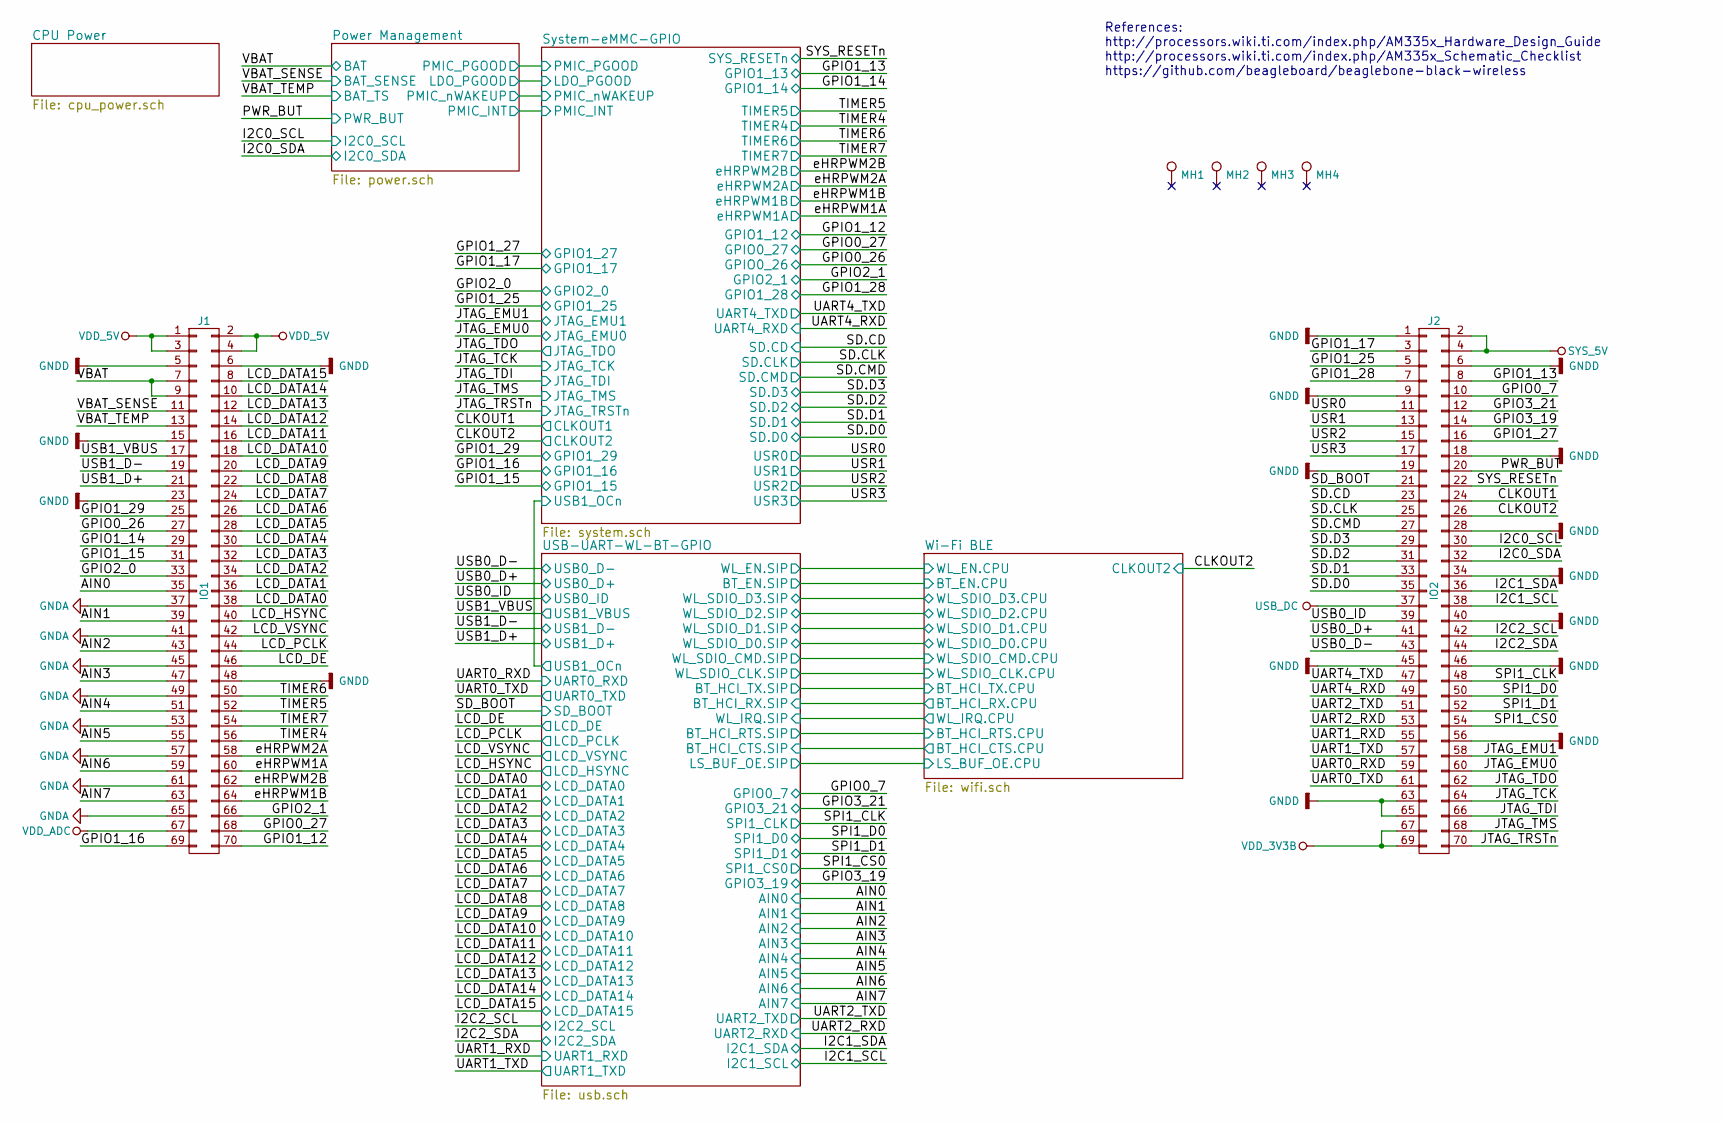
[picture p15: schematic mateboard.sch]

Parts:
J1: IO1; DF40C-70DP-0.4V_51_
J2: IO2; DF40C-70DP-0.4V_51_
MH1, MH2, MH3, MH4: Mounting hole; MountingHole_3.2mm_M3

Connections:
/AIN0: J1.35; also elsewhere on the board
/AIN1: J1.39; also elsewhere on the board
/AIN2: J1.43; also elsewhere on the board
/AIN3: J1.47; also elsewhere on the board
/AIN4: J1.51; also elsewhere on the board
/AIN5: J1.55; also elsewhere on the board
/AIN6: J1.59; also elsewhere on the board
/AIN7: J1.63; also elsewhere on the board
/CLKOUT1: J2.24; also elsewhere on the board
/CLKOUT2: J2.26; also elsewhere on the board
/GPIO0_7: J2.10; also elsewhere on the board
/GPIO0_26: J1.27; also elsewhere on the board
/GPIO0_27: J1.68; also elsewhere on the board
/GPIO1_12: J1.70; also elsewhere on the board
/GPIO1_13: J2.8; also elsewhere on the board
/GPIO1_14: J1.29; also elsewhere on the board
/GPIO1_15: J1.31; also elsewhere on the board
/GPIO1_16: J1.69; also elsewhere on the board
/GPIO1_17: J2.3; also elsewhere on the board
/GPIO1_25: J2.5; also elsewhere on the board
/GPIO1_27: J2.16; also elsewhere on the board
/GPIO1_28: J2.7; also elsewhere on the board
/GPIO1_29: J1.25; also elsewhere on the board
/GPIO2_0: J1.33; also elsewhere on the board
/GPIO2_1: J1.66; also elsewhere on the board
/GPIO3_19: J2.14; also elsewhere on the board
/GPIO3_21: J2.12; also elsewhere on the board
/I2C0_SCL: J2.30; also elsewhere on the board
/I2C0_SDA: J2.32; also elsewhere on the board
/I2C1_SCL: J2.38; also elsewhere on the board
/I2C1_SDA: J2.36; also elsewhere on the board
/I2C2_SCL: J2.42; also elsewhere on the board
/I2C2_SDA: J2.44; also elsewhere on the board
/JTAG_EMU0: J2.60; also elsewhere on the board
/JTAG_EMU1: J2.58; also elsewhere on the board
/JTAG_TCK: J2.64; also elsewhere on the board
/JTAG_TDI: J2.66; also elsewhere on the board
/JTAG_TDO: J2.62; also elsewhere on the board
/JTAG_TMS: J2.68; also elsewhere on the board
/JTAG_TRSTn: J2.70; also elsewhere on the board
/LCD_DATA0: J1.38; also elsewhere on the board
/LCD_DATA1: J1.36; also elsewhere on the board
/LCD_DATA2: J1.34; also elsewhere on the board
/LCD_DATA3: J1.32; also elsewhere on the board
/LCD_DATA4: J1.30; also elsewhere on the board
/LCD_DATA5: J1.28; also elsewhere on the board
/LCD_DATA6: J1.26; also elsewhere on the board
/LCD_DATA7: J1.24; also elsewhere on the board
/LCD_DATA8: J1.22; also elsewhere on the board
/LCD_DATA9: J1.20; also elsewhere on the board
/LCD_DATA10: J1.18; also elsewhere on the board
/LCD_DATA11: J1.16; also elsewhere on the board
/LCD_DATA12: J1.14; also elsewhere on the board
/LCD_DATA13: J1.12; also elsewhere on the board
/LCD_DATA14: J1.10; also elsewhere on the board
/LCD_DATA15: J1.8; also elsewhere on the board
/LCD_DE: J1.46; also elsewhere on the board
/LCD_HSYNC: J1.40; also elsewhere on the board
/LCD_PCLK: J1.44; also elsewhere on the board
/LCD_VSYNC: J1.42; also elsewhere on the board
/PWR_BUT: J2.20; also elsewhere on the board
/SD.CD: J2.23; also elsewhere on the board
/SD.CLK: J2.25; also elsewhere on the board
/SD.CMD: J2.27; also elsewhere on the board
/SD.D0: J2.35; also elsewhere on the board
/SD.D1: J2.33; also elsewhere on the board
/SD.D2: J2.31; also elsewhere on the board
/SD.D3: J2.29; also elsewhere on the board
/SD_BOOT: J2.21; also elsewhere on the board
/SPI1_CLK: J2.48; also elsewhere on the board
/SPI1_CS0: J2.54; also elsewhere on the board
/SPI1_D0: J2.50; also elsewhere on the board
/SPI1_D1: J2.52; also elsewhere on the board
/SYS_RESETn: J2.22; also elsewhere on the board
/TIMER4: J1.56; also elsewhere on the board
/TIMER5: J1.52; also elsewhere on the board
/TIMER6: J1.50; also elsewhere on the board
/TIMER7: J1.54; also elsewhere on the board
/UART0_RXD: J2.59; also elsewhere on the board
/UART0_TXD: J2.61; also elsewhere on the board
/UART1_RXD: J2.55; also elsewhere on the board
/UART1_TXD: J2.57; also elsewhere on the board
/UART2_RXD: J2.53; also elsewhere on the board
/UART2_TXD: J2.51; also elsewhere on the board
/UART4_RXD: J2.49; also elsewhere on the board
/UART4_TXD: J2.47; also elsewhere on the board
/USB0_D+: J2.41; also elsewhere on the board
/USB0_D-: J2.43; also elsewhere on the board
/USB0_ID: J2.39; also elsewhere on the board
/USB1_D+: J1.21; also elsewhere on the board
/USB1_D-: J1.19; also elsewhere on the board
/USB1_VBUS: J1.17; also elsewhere on the board
/USR0: J2.11; also elsewhere on the board
/USR1: J2.13; also elsewhere on the board
/USR2: J2.15; also elsewhere on the board
/USR3: J2.17; also elsewhere on the board
/VBAT: J1.7, J1.9; also elsewhere on the board
/VBAT_SENSE: J1.11; also elsewhere on the board
/VBAT_TEMP: J1.13; also elsewhere on the board
/eHRPWM1A: J1.60; also elsewhere on the board
/eHRPWM1B: J1.64; also elsewhere on the board
/eHRPWM2A: J1.58; also elsewhere on the board
/eHRPWM2B: J1.62; also elsewhere on the board
GNDA: J1.37, J1.41, J1.45, J1.49, J1.53, J1.57, J1.61, J1.65; also elsewhere on the board
GNDD: J1.5, J1.6, J1.15, J1.23, J1.48, J2.1, J2.6, J2.9, J2.18, J2.19, J2.28, J2.34, J2.40, J2.45, J2.46, J2.56, J2.63, J2.65; also elsewhere on the board
SYS_5V: J2.2, J2.4; also elsewhere on the board
USB_DC: J2.37; also elsewhere on the board
VDD_3V3B: J2.67, J2.69; also elsewhere on the board
VDD_5V: J1.1, J1.2, J1.3, J1.4; also elsewhere on the board
VDD_ADC: J1.67; also elsewhere on the board

Notes on the sheet:
References: http://processors.wiki.ti.com/index.php/AM335x_Hardware_Design_Guide http://processors.wiki.ti.com/index.php/AM335x_Schematic_Checklist https://github.com/beagleboard/beaglebone-black-wireless

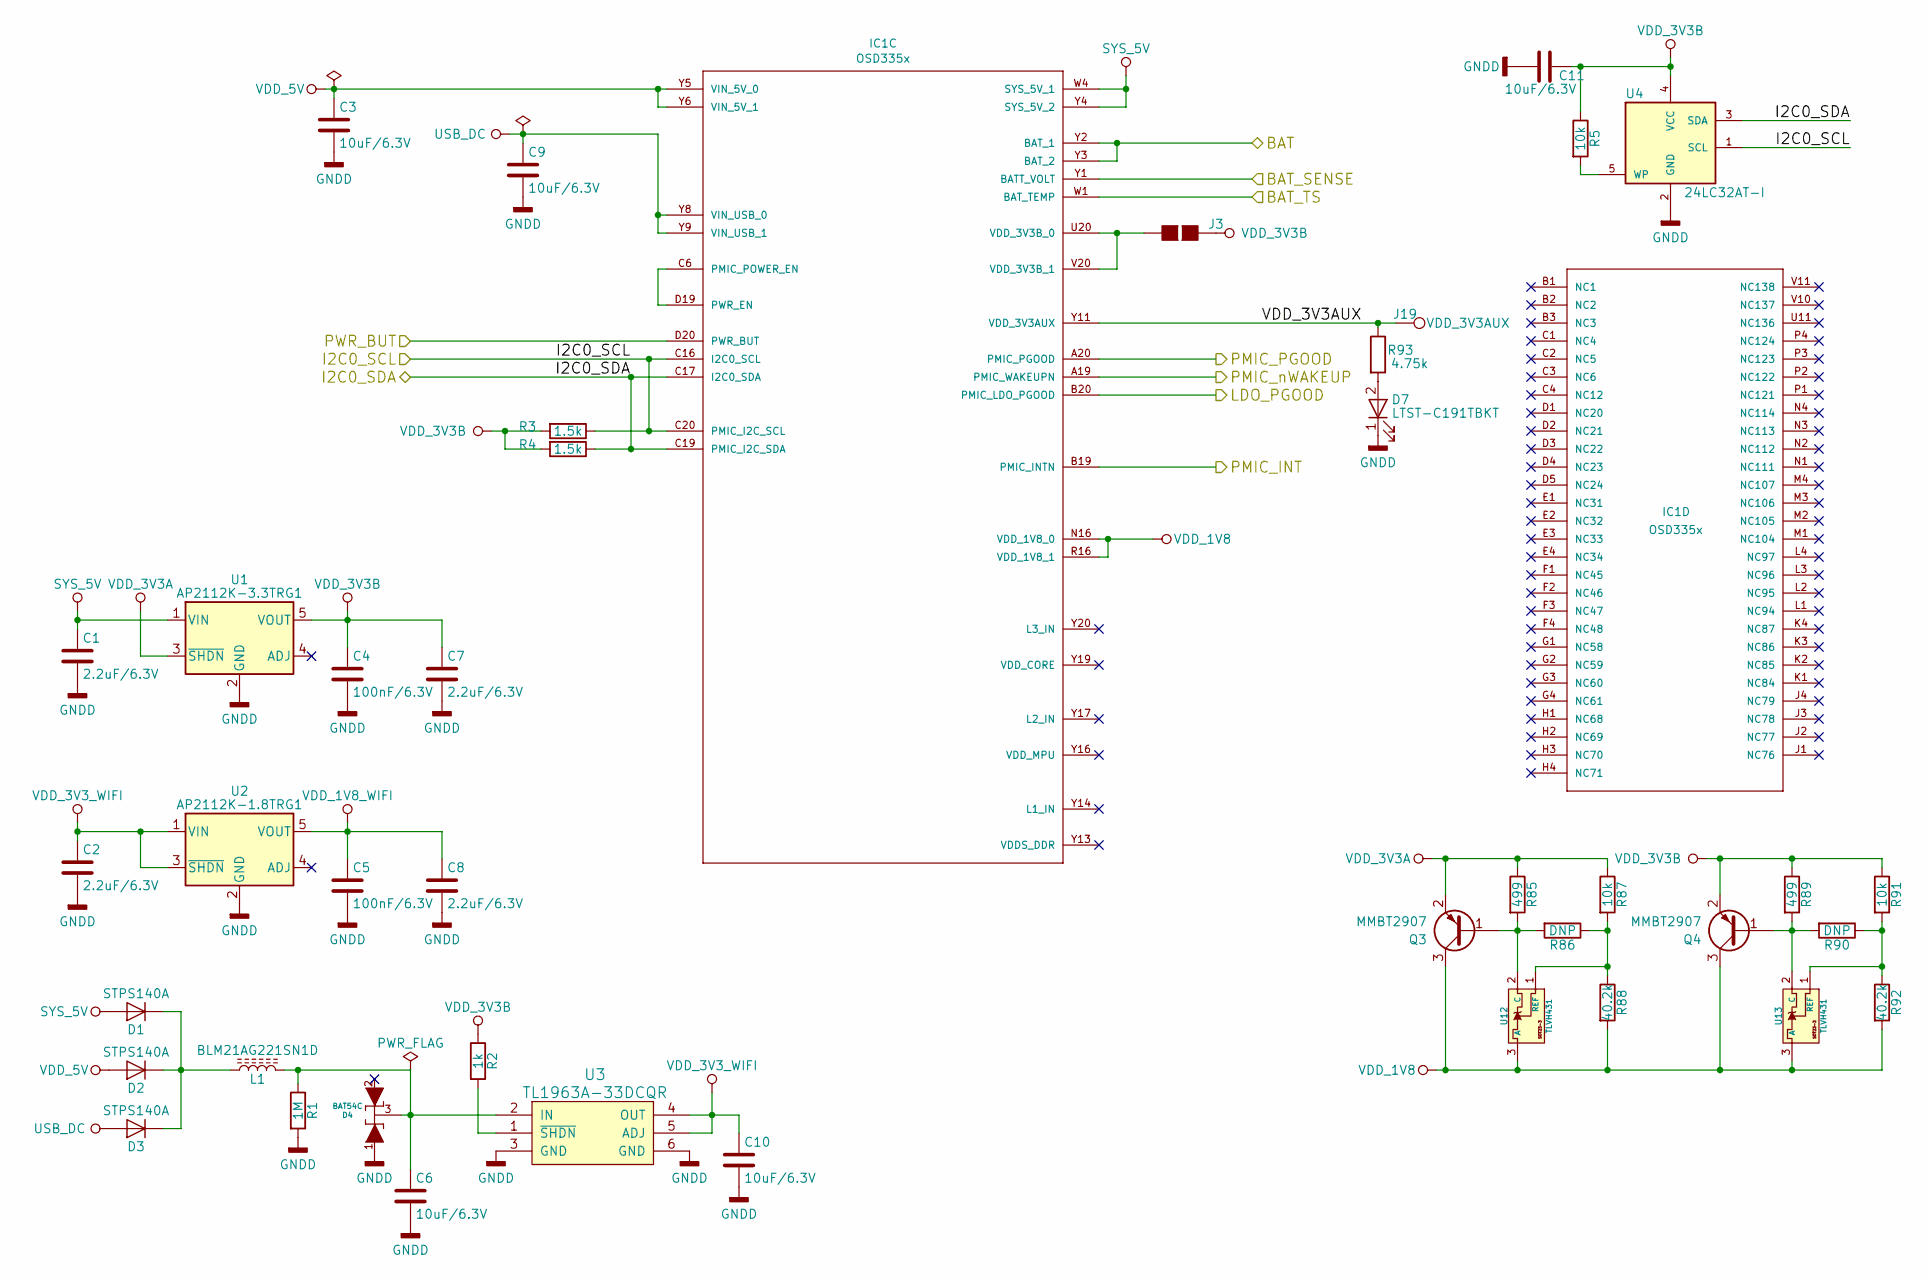
[picture p16: schematic power.sch, Mateboard]

Parts:
C1, C2, C7, C8: 2.2uF/6.3V; C_0603
C3, C6, C9, C10, C11: 10uF/6.3V; C_0603
C4, C5: 100nF/6.3V; C_0402
D1, D2, D3: STPS140A; D_SMA_Standard
D4: BAT54C; SOT-23
D7: LTST-C191TBKT; LED_0603
IC1: OSD335x; OSD3358-BAS-BGA400
J3: GS2
J19: VDD_3V3AUX; Measurement_Point_Round-SMD-Pad_Small
L1: BLM21AG221SN1D; R_0805
Q3, Q4: MMBT2907; SOT-23
R1: 1M; R_0402
R2: 1k; R_0402
R3, R4: 1.5k; R_0402
R5, R87, R91: 10k; R_0402
R85, R89: 499; R_0402
R86, R90: DNP; R_0402
R88, R92: 40.2k; R_0402
R93: 4.75k; R_0402
U1: AP2112K-3.3TRG1; TSOT-23-5
U2: AP2112K-1.8TRG1; TSOT-23-5
U3: TL1963A-33DCQR; SOT-223-6
U4: 24LC32AT-I; SOT-23-5
U12, U13: TLVH431; SOT-23

Connections:
/I2C0_SCL: IC1.C16 (I2C0_SCL), IC1.C20 (PMIC_I2C_SCL), R3.1, U4.1 (SCL); also elsewhere on the board
/I2C0_SDA: IC1.C17 (I2C0_SDA), IC1.C19 (PMIC_I2C_SDA), R4.1, U4.3 (SDA); also elsewhere on the board
/PWR_BUT: IC1.D20 (PWR_BUT); also elsewhere on the board
/Power Management/LDO_PGOOD: IC1.B20 (PMIC_LDO_PGOOD); also elsewhere on the board
/Power Management/PMIC_INT: IC1.B19 (PMIC_INTN); also elsewhere on the board
/Power Management/PMIC_PGOOD: IC1.A20 (PMIC_PGOOD); also elsewhere on the board
/Power Management/PMIC_nWAKEUP: IC1.A19 (PMIC_WAKEUPN); also elsewhere on the board
/Power Management/VDD_3V3AUX: IC1.Y11 (VDD_3V3AUX), J19.1, R93.1
/VBAT: IC1.Y2 (BAT_1), IC1.Y3 (BAT_2); also elsewhere on the board
/VBAT_SENSE: IC1.Y1 (BATT_VOLT); also elsewhere on the board
/VBAT_TEMP: IC1.W1 (BAT_TEMP); also elsewhere on the board
GNDD: C1.2, C2.2, C3.2, C4.2, C5.2, C6.2, C7.2, C8.2, C9.2, C10.2, C11.2, D4.1 (B), D7.1 (K), R1.2, U1.2 (GND), U2.2 (GND), U3.3 (GND), U3.6 (GND), U4.2 (GND); also elsewhere on the board
unnamed: C6.1, D4.3 (C), L1.2, R1.1, U3.2 (IN)
unnamed: D1.1 (K), D2.1 (K), D3.1 (K), L1.1
unnamed: D7.2 (A), R93.2
unnamed: IC1.C6 (PMIC_POWER_EN), IC1.D19 (PWR_EN)
unnamed: IC1.U20 (VDD_3V3B_0), IC1.V20 (VDD_3V3B_1), J3.2 (G2)
unnamed: Q3.1 (B), R85.2, R86.2, U12.2 (C)
unnamed: Q4.1 (B), R89.2, R90.2, U13.2 (C)
unnamed: R2.2, U3.1 (~SHDN)
unnamed: R5.2, U4.5 (WP)
unnamed: R86.1, R87.2, R88.1, U12.1 (REF)
unnamed: R90.1, R91.2, R92.1, U13.1 (REF)
SYS_5V: C1.1, D1.2 (A), IC1.W4 (SYS_5V_1), IC1.Y4 (SYS_5V_2), U1.1 (VIN); also elsewhere on the board
USB_DC: C9.1, D3.2 (A), IC1.Y8 (VIN_USB_0), IC1.Y9 (VIN_USB_1); also elsewhere on the board
VDD_1V8: IC1.N16 (VDD_1V8_0), IC1.R16 (VDD_1V8_1), Q3.3 (C), Q4.3 (C), R88.2, R92.2, U12.3 (A), U13.3 (A); also elsewhere on the board
VDD_1V8_WIFI: C5.1, C8.1, U2.5 (VOUT); also elsewhere on the board
VDD_3V3A: Q3.2 (E), R85.1, R87.1, U1.3 (~SHDN); also elsewhere on the board
VDD_3V3B: C4.1, C7.1, C11.1, J3.1 (G1), Q4.2 (E), R2.1, R3.2, R4.2, R5.1, R89.1, R91.1, U1.5 (VOUT), U4.4 (VCC); also elsewhere on the board
VDD_3V3_WIFI: C2.1, C10.1, U2.1 (VIN), U2.3 (~SHDN), U3.4 (OUT), U3.5 (ADJ); also elsewhere on the board
VDD_5V: C3.1, D2.2 (A), IC1.Y5 (VIN_5V_0), IC1.Y6 (VIN_5V_1); also elsewhere on the board

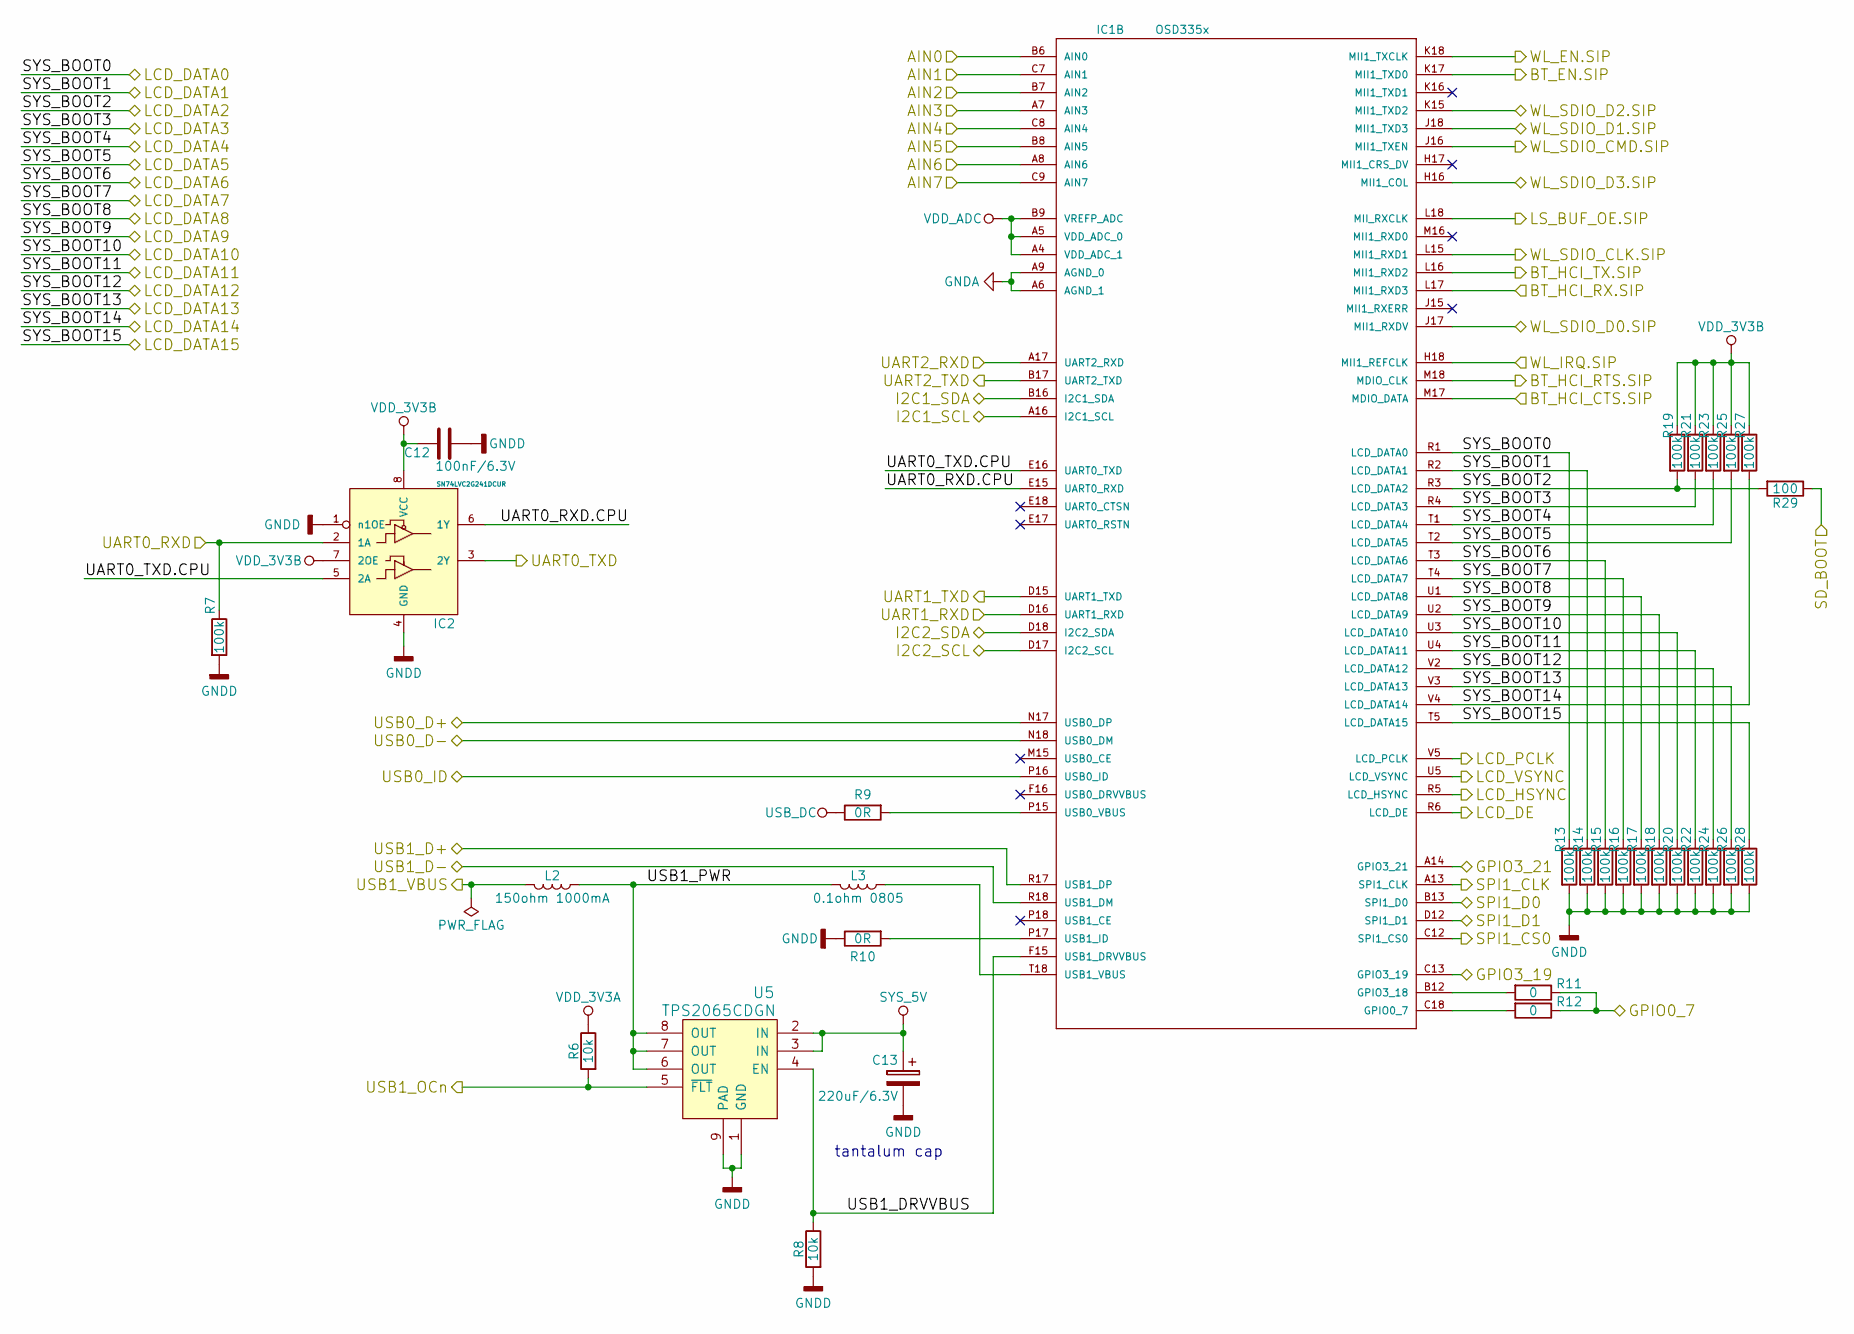
[picture p17: schematic usb.sch, Mateboard]

Parts:
C12: 100nF/6.3V; C_0402
C13: 220uF/6.3V; CP_Tantalum_Case-A_EIA-3216-18_Reflow
IC1: OSD335x; OSD3358-BAS-BGA400
IC2: SN74LVC2G241DCUR; VSSOP-8_2.3x2mm_Pitch0.5mm
L2: 150ohm 1000mA; R_0805
L3: 0.1ohm 0805; R_0805
R6, R8: 10k; R_0402
R7, R13, R14, R15, R16, R17, R18, R19, R20, R21, R22, R23, R24, R25, R26, R27, R28: 100k; R_0402
R9, R10: 0R; R_0402
R11, R12: 0; R_0402
R29: 100; R_0402
U5: TPS2065CDGN; MSOP-8-1EP_3x3mm_Pitch0.65mm

Connections:
/AIN0: IC1.B6 (AIN0); also elsewhere on the board
/AIN1: IC1.C7 (AIN1); also elsewhere on the board
/AIN2: IC1.B7 (AIN2); also elsewhere on the board
/AIN3: IC1.A7 (AIN3); also elsewhere on the board
/AIN4: IC1.C8 (AIN4); also elsewhere on the board
/AIN5: IC1.B8 (AIN5); also elsewhere on the board
/AIN6: IC1.A8 (AIN6); also elsewhere on the board
/AIN7: IC1.C9 (AIN7); also elsewhere on the board
/GPIO0_7: R11.1, R12.1; also elsewhere on the board
/GPIO3_19: IC1.C13 (GPIO3_19); also elsewhere on the board
/GPIO3_21: IC1.A14 (GPIO3_21); also elsewhere on the board
/I2C1_SCL: IC1.A16 (I2C1_SCL); also elsewhere on the board
/I2C1_SDA: IC1.B16 (I2C1_SDA); also elsewhere on the board
/I2C2_SCL: IC1.D17 (I2C2_SCL); also elsewhere on the board
/I2C2_SDA: IC1.D18 (I2C2_SDA); also elsewhere on the board
/LCD_DATA0: IC1.R1 (LCD_DATA0), R13.1; also elsewhere on the board
/LCD_DATA1: IC1.R2 (LCD_DATA1), R14.1; also elsewhere on the board
/LCD_DATA2: IC1.R3 (LCD_DATA2), R19.2, R29.2; also elsewhere on the board
/LCD_DATA3: IC1.R4 (LCD_DATA3), R21.2; also elsewhere on the board
/LCD_DATA4: IC1.T1 (LCD_DATA4), R23.2; also elsewhere on the board
/LCD_DATA5: IC1.T2 (LCD_DATA5), R25.2; also elsewhere on the board
/LCD_DATA6: IC1.T3 (LCD_DATA6), R15.1; also elsewhere on the board
/LCD_DATA7: IC1.T4 (LCD_DATA7), R16.1; also elsewhere on the board
/LCD_DATA8: IC1.U1 (LCD_DATA8), R17.1; also elsewhere on the board
/LCD_DATA9: IC1.U2 (LCD_DATA9), R18.1; also elsewhere on the board
/LCD_DATA10: IC1.U3 (LCD_DATA10), R20.1; also elsewhere on the board
/LCD_DATA11: IC1.U4 (LCD_DATA11), R22.1; also elsewhere on the board
/LCD_DATA12: IC1.V2 (LCD_DATA12), R24.1; also elsewhere on the board
/LCD_DATA13: IC1.V3 (LCD_DATA13), R26.1; also elsewhere on the board
/LCD_DATA14: IC1.V4 (LCD_DATA14), R27.2; also elsewhere on the board
/LCD_DATA15: IC1.T5 (LCD_DATA15), R28.1; also elsewhere on the board
/LCD_DE: IC1.R6 (LCD_DE); also elsewhere on the board
/LCD_HSYNC: IC1.R5 (LCD_HSYNC); also elsewhere on the board
/LCD_PCLK: IC1.V5 (LCD_PCLK); also elsewhere on the board
/LCD_VSYNC: IC1.U5 (LCD_VSYNC); also elsewhere on the board
/SD_BOOT: R29.1; also elsewhere on the board
/SPI1_CLK: IC1.A13 (SPI1_CLK); also elsewhere on the board
/SPI1_CS0: IC1.C12 (SPI1_CS0); also elsewhere on the board
/SPI1_D0: IC1.B13 (SPI1_D0); also elsewhere on the board
/SPI1_D1: IC1.D12 (SPI1_D1); also elsewhere on the board
/System-eMMC-GPIO/USB1_OCn: R6.2, U5.5 (~FLT); also elsewhere on the board
/UART0_RXD: IC2.2 (1A), R7.1; also elsewhere on the board
/UART0_TXD: IC2.3 (2Y); also elsewhere on the board
/UART1_RXD: IC1.D16 (UART1_RXD); also elsewhere on the board
/UART1_TXD: IC1.D15 (UART1_TXD); also elsewhere on the board
/UART2_RXD: IC1.A17 (UART2_RXD); also elsewhere on the board
/UART2_TXD: IC1.B17 (UART2_TXD); also elsewhere on the board
/USB0_D+: IC1.N17 (USB0_DP); also elsewhere on the board
/USB0_D-: IC1.N18 (USB0_DM); also elsewhere on the board
/USB0_ID: IC1.P16 (USB0_ID); also elsewhere on the board
/USB1_D+: IC1.R17 (USB1_DP); also elsewhere on the board
/USB1_D-: IC1.R18 (USB1_DM); also elsewhere on the board
/USB1_VBUS: L2.1; also elsewhere on the board
/USB-UART-WL-BT-GPIO/UART0_RXD.CPU: IC1.E15 (UART0_RXD), IC2.6 (1Y)
/USB-UART-WL-BT-GPIO/UART0_TXD.CPU: IC1.E16 (UART0_TXD), IC2.5 (2A)
/USB-UART-WL-BT-GPIO/USB1_DRVVBUS: IC1.F15 (USB1_DRVVBUS), R8.1, U5.4 (EN)
/USB-UART-WL-BT-GPIO/USB1_PWR: L2.2, L3.1, U5.6 (OUT), U5.7 (OUT), U5.8 (OUT)
/Wi-Fi BLE/BT_EN.CPU: IC1.K17 (MII1_TXD0); also elsewhere on the board
/Wi-Fi BLE/BT_HCI_CTS.CPU: IC1.M17 (MDIO_DATA); also elsewhere on the board
/Wi-Fi BLE/BT_HCI_RTS.CPU: IC1.M18 (MDIO_CLK); also elsewhere on the board
/Wi-Fi BLE/BT_HCI_RX.CPU: IC1.L17 (MII1_RXD3); also elsewhere on the board
/Wi-Fi BLE/BT_HCI_TX.CPU: IC1.L16 (MII1_RXD2); also elsewhere on the board
/Wi-Fi BLE/LS_BUF_OE.CPU: IC1.L18 (MII_RXCLK); also elsewhere on the board
/Wi-Fi BLE/WL_EN.CPU: IC1.K18 (MII1_TXCLK); also elsewhere on the board
/Wi-Fi BLE/WL_IRQ.CPU: IC1.H18 (MII1_REFCLK); also elsewhere on the board
/Wi-Fi BLE/WL_SDIO_CLK.CPU: IC1.L15 (MII1_RXD1); also elsewhere on the board
/Wi-Fi BLE/WL_SDIO_CMD.CPU: IC1.J16 (MII1_TXEN); also elsewhere on the board
/Wi-Fi BLE/WL_SDIO_D0.CPU: IC1.J17 (MII1_RXDV); also elsewhere on the board
/Wi-Fi BLE/WL_SDIO_D1.CPU: IC1.J18 (MII1_TXD3); also elsewhere on the board
/Wi-Fi BLE/WL_SDIO_D2.CPU: IC1.K15 (MII1_TXD2); also elsewhere on the board
/Wi-Fi BLE/WL_SDIO_D3.CPU: IC1.H16 (MII1_COL); also elsewhere on the board
GNDA: IC1.A6 (AGND_1), IC1.A9 (AGND_0); also elsewhere on the board
GNDD: C12.2, C13.2, IC2.1 (n1OE), IC2.4 (GND), R7.2, R8.2, R10.1, R13.2, R14.2, R15.2, R16.2, R17.2, R18.2, R20.2, R22.2, R24.2, R26.2, R28.2, U5.1 (GND), U5.9 (PAD); also elsewhere on the board
unnamed: IC1.B12 (GPIO3_18), R11.2
unnamed: IC1.C18 (GPIO0_7), R12.2
unnamed: IC1.P15 (USB0_VBUS), R9.2
unnamed: IC1.P17 (USB1_ID), R10.2
unnamed: IC1.T18 (USB1_VBUS), L3.2
SYS_5V: C13.1, U5.2 (IN), U5.3 (IN); also elsewhere on the board
USB_DC: R9.1; also elsewhere on the board
VDD_3V3A: R6.1; also elsewhere on the board
VDD_3V3B: C12.1, IC2.7 (2OE), IC2.8 (VCC), R19.1, R21.1, R23.1, R25.1, R27.1; also elsewhere on the board
VDD_ADC: IC1.A4 (VDD_ADC_1), IC1.A5 (VDD_ADC_0), IC1.B9 (VREFP_ADC); also elsewhere on the board

Notes on the sheet:
tantalum cap

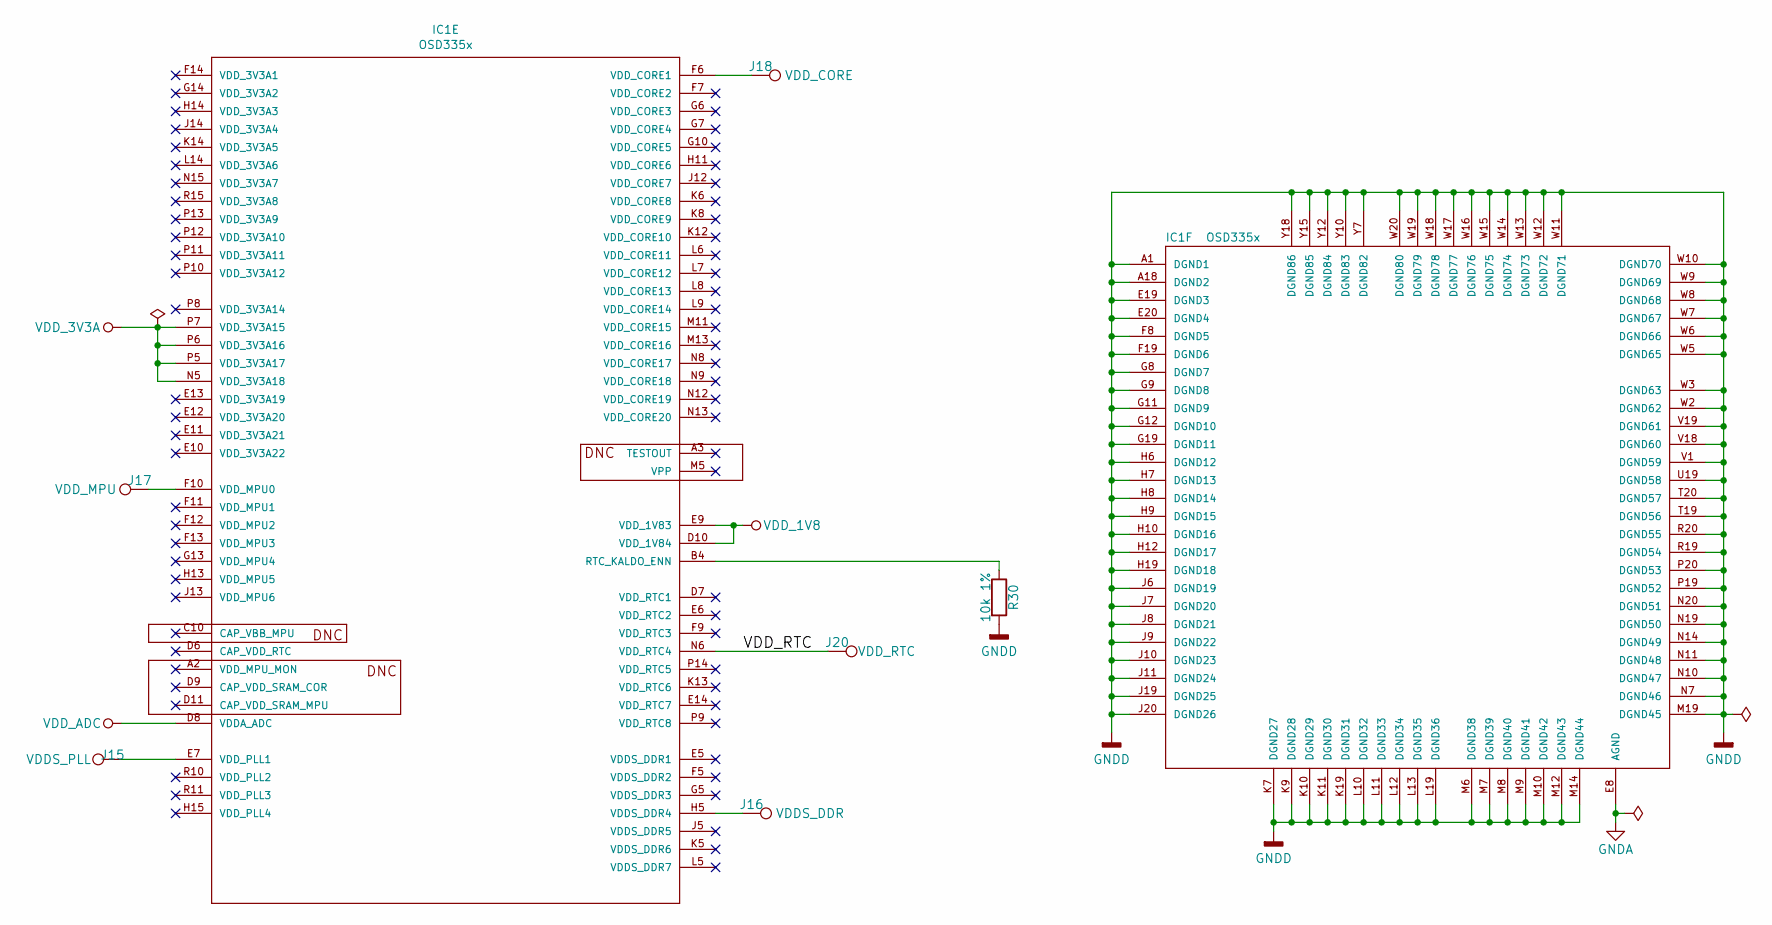
[picture p18: schematic cpu_power.sch, Mateboard]

Parts:
IC1: OSD335x; OSD3358-BAS-BGA400
J15: VDDS_PLL; Measurement_Point_Round-SMD-Pad_Small
J16: VDDS_DDR; Measurement_Point_Round-SMD-Pad_Small
J17: VDD_MPU; Measurement_Point_Round-SMD-Pad_Small
J18: VDD_CORE; Measurement_Point_Round-SMD-Pad_Small
J20: VDD_RTC; Measurement_Point_Round-SMD-Pad_Small
R30: 10k 1%; R_0402

Connections:
/CPU Power/VDD_RTC: IC1.N6 (VDD_RTC4), J20.1
GNDA: IC1.E8 (AGND); also elsewhere on the board
GNDD: IC1.A1 (DGND1), IC1.A18 (DGND2), IC1.E19 (DGND3), IC1.E20 (DGND4), IC1.F8 (DGND5), IC1.F19 (DGND6), IC1.G8 (DGND7), IC1.G9 (DGND8), IC1.G11 (DGND9), IC1.G12 (DGND10), IC1.G19 (DGND11), IC1.H6 (DGND12), IC1.H7 (DGND13), IC1.H8 (DGND14), IC1.H9 (DGND15), IC1.H10 (DGND16), IC1.H12 (DGND17), IC1.H19 (DGND18), IC1.J6 (DGND19), IC1.J7 (DGND20), IC1.J8 (DGND21), IC1.J9 (DGND22), IC1.J10 (DGND23), IC1.J11 (DGND24), IC1.J19 (DGND25), IC1.J20 (DGND26), IC1.K7 (DGND27), IC1.K9 (DGND28), IC1.K10 (DGND29), IC1.K11 (DGND30), IC1.K19 (DGND31), IC1.L10 (DGND32), IC1.L11 (DGND33), IC1.L12 (DGND34), IC1.L13 (DGND35), IC1.L19 (DGND36), IC1.M6 (DGND38), IC1.M7 (DGND39), IC1.M8 (DGND40), IC1.M9 (DGND41), IC1.M10 (DGND42), IC1.M12 (DGND43), IC1.M14 (DGND44), IC1.M19 (DGND45), IC1.N7 (DGND46), IC1.N10 (DGND47), IC1.N11 (DGND48), IC1.N14 (DGND49), IC1.N19 (DGND50), IC1.N20 (DGND51), IC1.P19 (DGND52), IC1.P20 (DGND53), IC1.R19 (DGND54), IC1.R20 (DGND55), IC1.T19 (DGND56), IC1.T20 (DGND57), IC1.U19 (DGND58), IC1.V1 (DGND59), IC1.V18 (DGND60), IC1.V19 (DGND61), IC1.W2 (DGND62), IC1.W3 (DGND63), IC1.W5 (DGND65), IC1.W6 (DGND66), IC1.W7 (DGND67), IC1.W8 (DGND68), IC1.W9 (DGND69), IC1.W10 (DGND70), IC1.W11 (DGND71), IC1.W12 (DGND72), IC1.W13 (DGND73), IC1.W14 (DGND74), IC1.W15 (DGND75), IC1.W16 (DGND76), IC1.W17 (DGND77), IC1.W18 (DGND78), IC1.W19 (DGND79), IC1.W20 (DGND80), IC1.Y7 (DGND82), IC1.Y10 (DGND83), IC1.Y12 (DGND84), IC1.Y15 (DGND85), IC1.Y18 (DGND86), R30.2; also elsewhere on the board
unnamed: IC1.B4 (RTC_KALDO_ENN), R30.1
unnamed: IC1.E7 (VDD_PLL1), J15.1
unnamed: IC1.F6 (VDD_CORE1), J18.1
unnamed: IC1.F10 (VDD_MPU0), J17.1
unnamed: IC1.H5 (VDDS_DDR4), J16.1
VDD_1V8: IC1.D10 (VDD_1V84), IC1.E9 (VDD_1V83); also elsewhere on the board
VDD_3V3A: IC1.N5 (VDD_3V3A18), IC1.P5 (VDD_3V3A17), IC1.P6 (VDD_3V3A16), IC1.P7 (VDD_3V3A15); also elsewhere on the board
VDD_ADC: IC1.D8 (VDDA_ADC); also elsewhere on the board
