pridolfi/mateboard/mateboard.kicad_pcb

## KiCad design mateboard.kicad_pcb (continued)

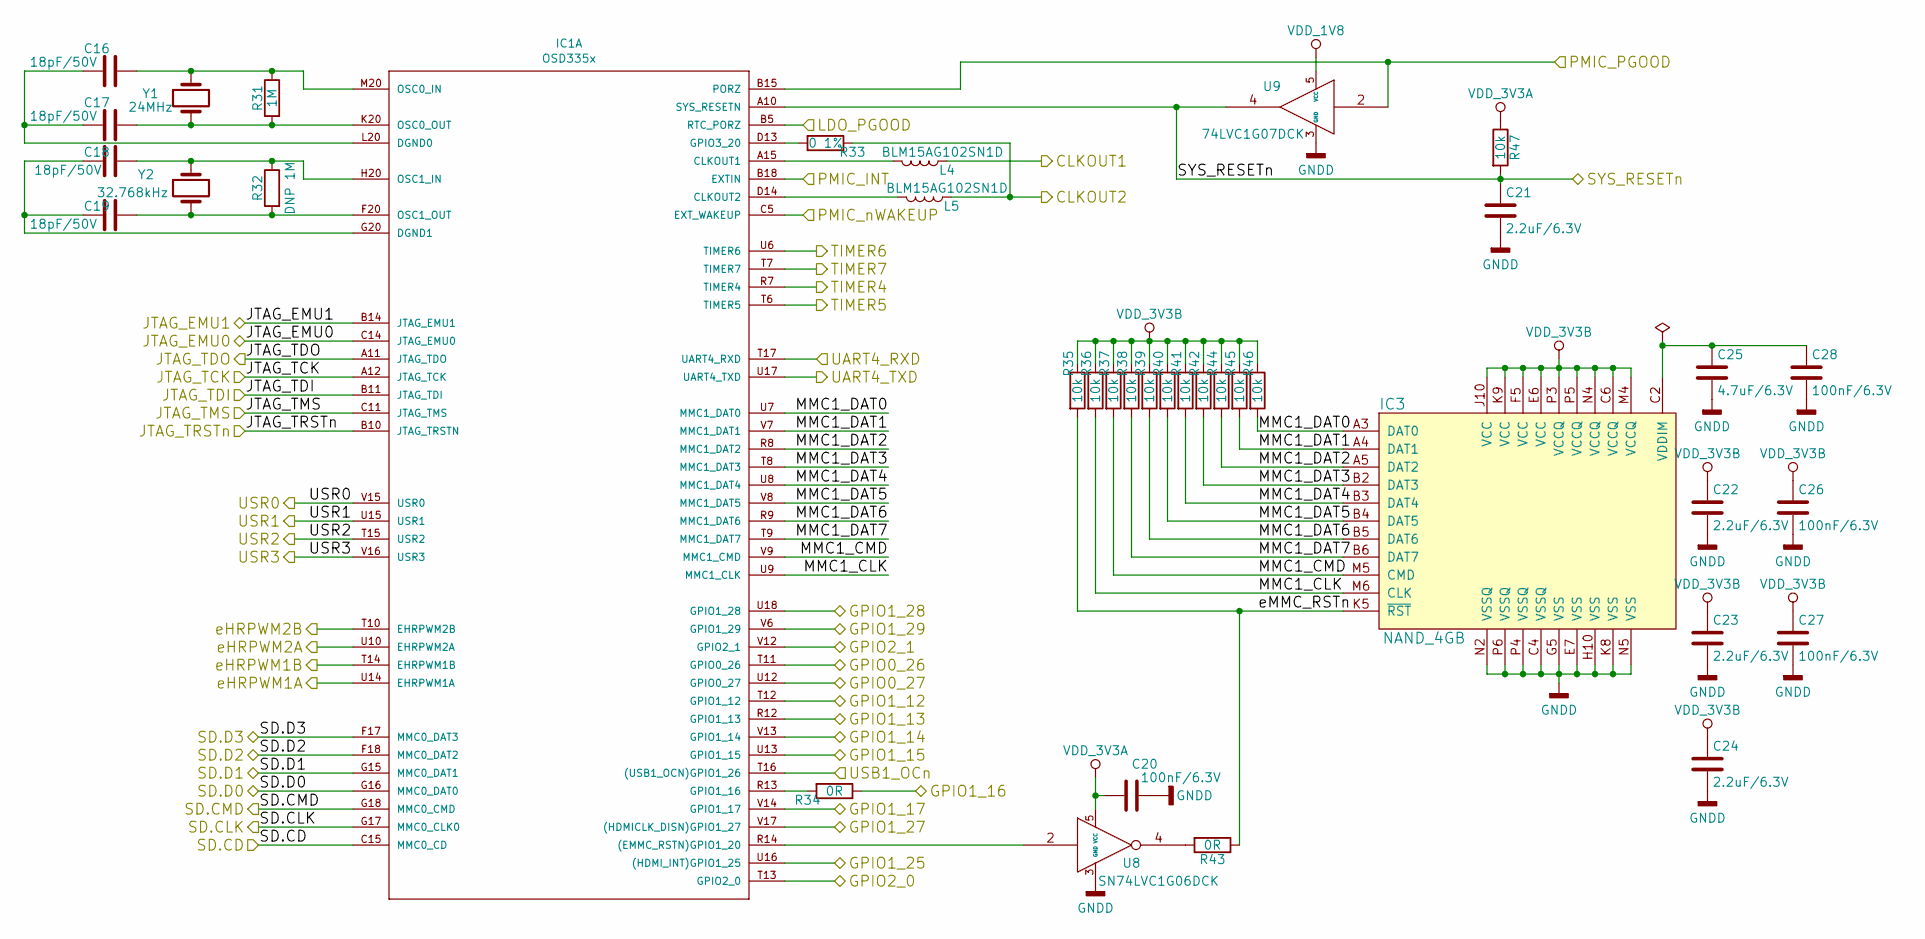
[picture p19: schematic system.sch, Mateboard]

Parts:
C16, C17, C18, C19: 18pF/50V; C_0402
C20, C26, C27, C28: 100nF/6.3V; C_0402
C21, C22, C23, C24: 2.2uF/6.3V; C_0603
C25: 4.7uF/6.3V; C_0805
IC1: OSD335x; OSD3358-BAS-BGA400
IC3: NAND_4GB; BeagleBone_Blue-GHI-IC_MICRON_EMMC_153_MODIFICADO
L4, L5: BLM15AG102SN1D; R_0402
R31: 1M; R_0402
R32: DNP 1M; R_0402
R33: 0 1%; R_0402
R34, R43: 0R; R_0402
R35, R36, R37, R38, R39, R40, R41, R42, R44, R45, R46, R47: 10k; R_0402
U8: SN74LVC1G06DCK; SOT-353_SC-70-5
U9: 74LVC1G07DCK; SOT-353_SC-70-5
Y1: 24MHz; Crystal_SMD_5032-2pin_5.0x3.2mm
Y2: 32.768kHz; Crystal_SMD_3215-2pin_3.2x1.5mm

Connections:
/CLKOUT1: L4.1; also elsewhere on the board
/CLKOUT2: L5.1, R33.1; also elsewhere on the board
/GPIO0_26: IC1.T11 (GPIO0_26); also elsewhere on the board
/GPIO0_27: IC1.U12 (GPIO0_27); also elsewhere on the board
/GPIO1_12: IC1.T12 (GPIO1_12); also elsewhere on the board
/GPIO1_13: IC1.R12 (GPIO1_13); also elsewhere on the board
/GPIO1_14: IC1.V13 (GPIO1_14); also elsewhere on the board
/GPIO1_15: IC1.U13 (GPIO1_15); also elsewhere on the board
/GPIO1_16: R34.1; also elsewhere on the board
/GPIO1_17: IC1.V14 (GPIO1_17); also elsewhere on the board
/GPIO1_25: IC1.U16 ((HDMI_INT)GPIO1_25); also elsewhere on the board
/GPIO1_27: IC1.V17 ((HDMICLK_DISN)GPIO1_27); also elsewhere on the board
/GPIO1_28: IC1.U18 (GPIO1_28); also elsewhere on the board
/GPIO1_29: IC1.V6 (GPIO1_29); also elsewhere on the board
/GPIO2_0: IC1.T13 (GPIO2_0); also elsewhere on the board
/GPIO2_1: IC1.V12 (GPIO2_1); also elsewhere on the board
/JTAG_EMU0: IC1.C14 (JTAG_EMU0); also elsewhere on the board
/JTAG_EMU1: IC1.B14 (JTAG_EMU1); also elsewhere on the board
/JTAG_TCK: IC1.A12 (JTAG_TCK); also elsewhere on the board
/JTAG_TDI: IC1.B11 (JTAG_TDI); also elsewhere on the board
/JTAG_TDO: IC1.A11 (JTAG_TDO); also elsewhere on the board
/JTAG_TMS: IC1.C11 (JTAG_TMS); also elsewhere on the board
/JTAG_TRSTn: IC1.B10 (JTAG_TRSTN); also elsewhere on the board
/Power Management/LDO_PGOOD: IC1.B5 (RTC_PORZ); also elsewhere on the board
/Power Management/PMIC_INT: IC1.B18 (EXTIN); also elsewhere on the board
/Power Management/PMIC_PGOOD: IC1.B15 (PORZ), U9.2; also elsewhere on the board
/Power Management/PMIC_nWAKEUP: IC1.C5 (EXT_WAKEUP); also elsewhere on the board
/SD.CD: IC1.C15 (MMC0_CD); also elsewhere on the board
/SD.CLK: IC1.G17 (MMC0_CLK0); also elsewhere on the board
/SD.CMD: IC1.G18 (MMC0_CMD); also elsewhere on the board
/SD.D0: IC1.G16 (MMC0_DAT0); also elsewhere on the board
/SD.D1: IC1.G15 (MMC0_DAT1); also elsewhere on the board
/SD.D2: IC1.F18 (MMC0_DAT2); also elsewhere on the board
/SD.D3: IC1.F17 (MMC0_DAT3); also elsewhere on the board
/SYS_RESETn: C21.1, IC1.A10 (SYS_RESETN), R47.2, U9.4; also elsewhere on the board
/System-eMMC-GPIO/MMC1_CLK: IC1.U9 (MMC1_CLK), IC3.M6 (CLK), R36.2
/System-eMMC-GPIO/MMC1_CMD: IC1.V9 (MMC1_CMD), IC3.M5 (CMD), R37.2
/System-eMMC-GPIO/MMC1_DAT0: IC1.U7 (MMC1_DAT0), IC3.A3 (DAT0), R46.2
/System-eMMC-GPIO/MMC1_DAT1: IC1.V7 (MMC1_DAT1), IC3.A4 (DAT1), R45.2
/System-eMMC-GPIO/MMC1_DAT2: IC1.R8 (MMC1_DAT2), IC3.A5 (DAT2), R44.2
/System-eMMC-GPIO/MMC1_DAT3: IC1.T8 (MMC1_DAT3), IC3.B2 (DAT3), R42.2
/System-eMMC-GPIO/MMC1_DAT4: IC1.U8 (MMC1_DAT4), IC3.B3 (DAT4), R41.2
/System-eMMC-GPIO/MMC1_DAT5: IC1.V8 (MMC1_DAT5), IC3.B4 (DAT5), R40.2
/System-eMMC-GPIO/MMC1_DAT6: IC1.R9 (MMC1_DAT6), IC3.B5 (DAT6), R39.2
/System-eMMC-GPIO/MMC1_DAT7: IC1.T9 (MMC1_DAT7), IC3.B6 (DAT7), R38.2
/System-eMMC-GPIO/USB1_OCn: IC1.T16 ((USB1_OCN)GPIO1_26); also elsewhere on the board
/System-eMMC-GPIO/eMMC_RSTn: IC3.K5 (~RST), R35.2, R43.1
/TIMER4: IC1.R7 (TIMER4); also elsewhere on the board
/TIMER5: IC1.T6 (TIMER5); also elsewhere on the board
/TIMER6: IC1.U6 (TIMER6); also elsewhere on the board
/TIMER7: IC1.T7 (TIMER7); also elsewhere on the board
/UART4_RXD: IC1.T17 (UART4_RXD); also elsewhere on the board
/UART4_TXD: IC1.U17 (UART4_TXD); also elsewhere on the board
/USR0: IC1.V15 (USR0); also elsewhere on the board
/USR1: IC1.U15 (USR1); also elsewhere on the board
/USR2: IC1.T15 (USR2); also elsewhere on the board
/USR3: IC1.V16 (USR3); also elsewhere on the board
/eHRPWM1A: IC1.U14 (EHRPWM1A); also elsewhere on the board
/eHRPWM1B: IC1.T14 (EHRPWM1B); also elsewhere on the board
/eHRPWM2A: IC1.U10 (EHRPWM2A); also elsewhere on the board
/eHRPWM2B: IC1.T10 (EHRPWM2B); also elsewhere on the board
GNDD: C20.2, C21.2, C22.2, C23.2, C24.2, C25.2, C26.2, C27.2, C28.2, IC3.C4 (VSSQ), IC3.E7 (VSS), IC3.G5 (VSS), IC3.H10 (VSS), IC3.K8 (VSS), IC3.N2 (VSSQ), IC3.N5 (VSS), IC3.P4 (VSSQ), IC3.P6 (VSSQ), U8.3 (GND), U9.3 (GND); also elsewhere on the board
unnamed: C16.1, IC1.M20 (OSC0_IN), R31.1, Y1.1
unnamed: C16.2, C17.2, IC1.L20 (DGND0)
unnamed: C17.1, IC1.K20 (OSC0_OUT), R31.2, Y1.2
unnamed: C18.1, IC1.H20 (OSC1_IN), R32.1, Y2.1
unnamed: C18.2, C19.2, IC1.G20 (DGND1)
unnamed: C19.1, IC1.F20 (OSC1_OUT), R32.2, Y2.2
unnamed: C25.1, C28.1, IC3.C2 (VDDIM)
unnamed: IC1.A15 (CLKOUT1), L4.2
unnamed: IC1.D13 (GPIO3_20), R33.2
unnamed: IC1.D14 (CLKOUT2), L5.2
unnamed: IC1.R13 (GPIO1_16), R34.2
unnamed: IC1.R14 ((EMMC_RSTN)GPIO1_20), U8.2
unnamed: R43.2, U8.4
VDD_1V8: U9.5 (VCC); also elsewhere on the board
VDD_3V3A: C20.1, R47.1, U8.5 (VCC); also elsewhere on the board
VDD_3V3B: C22.1, C23.1, C24.1, C26.1, C27.1, IC3.C6 (VCCQ), IC3.E6 (VCC), IC3.F5 (VCC), IC3.J10 (VCC), IC3.K9 (VCC), IC3.M4 (VCCQ), IC3.N4 (VCCQ), IC3.P3 (VCCQ), IC3.P5 (VCCQ), R35.1, R36.1, R37.1, R38.1, R39.1, R40.1, R41.1, R42.1, R44.1, R45.1, R46.1; also elsewhere on the board

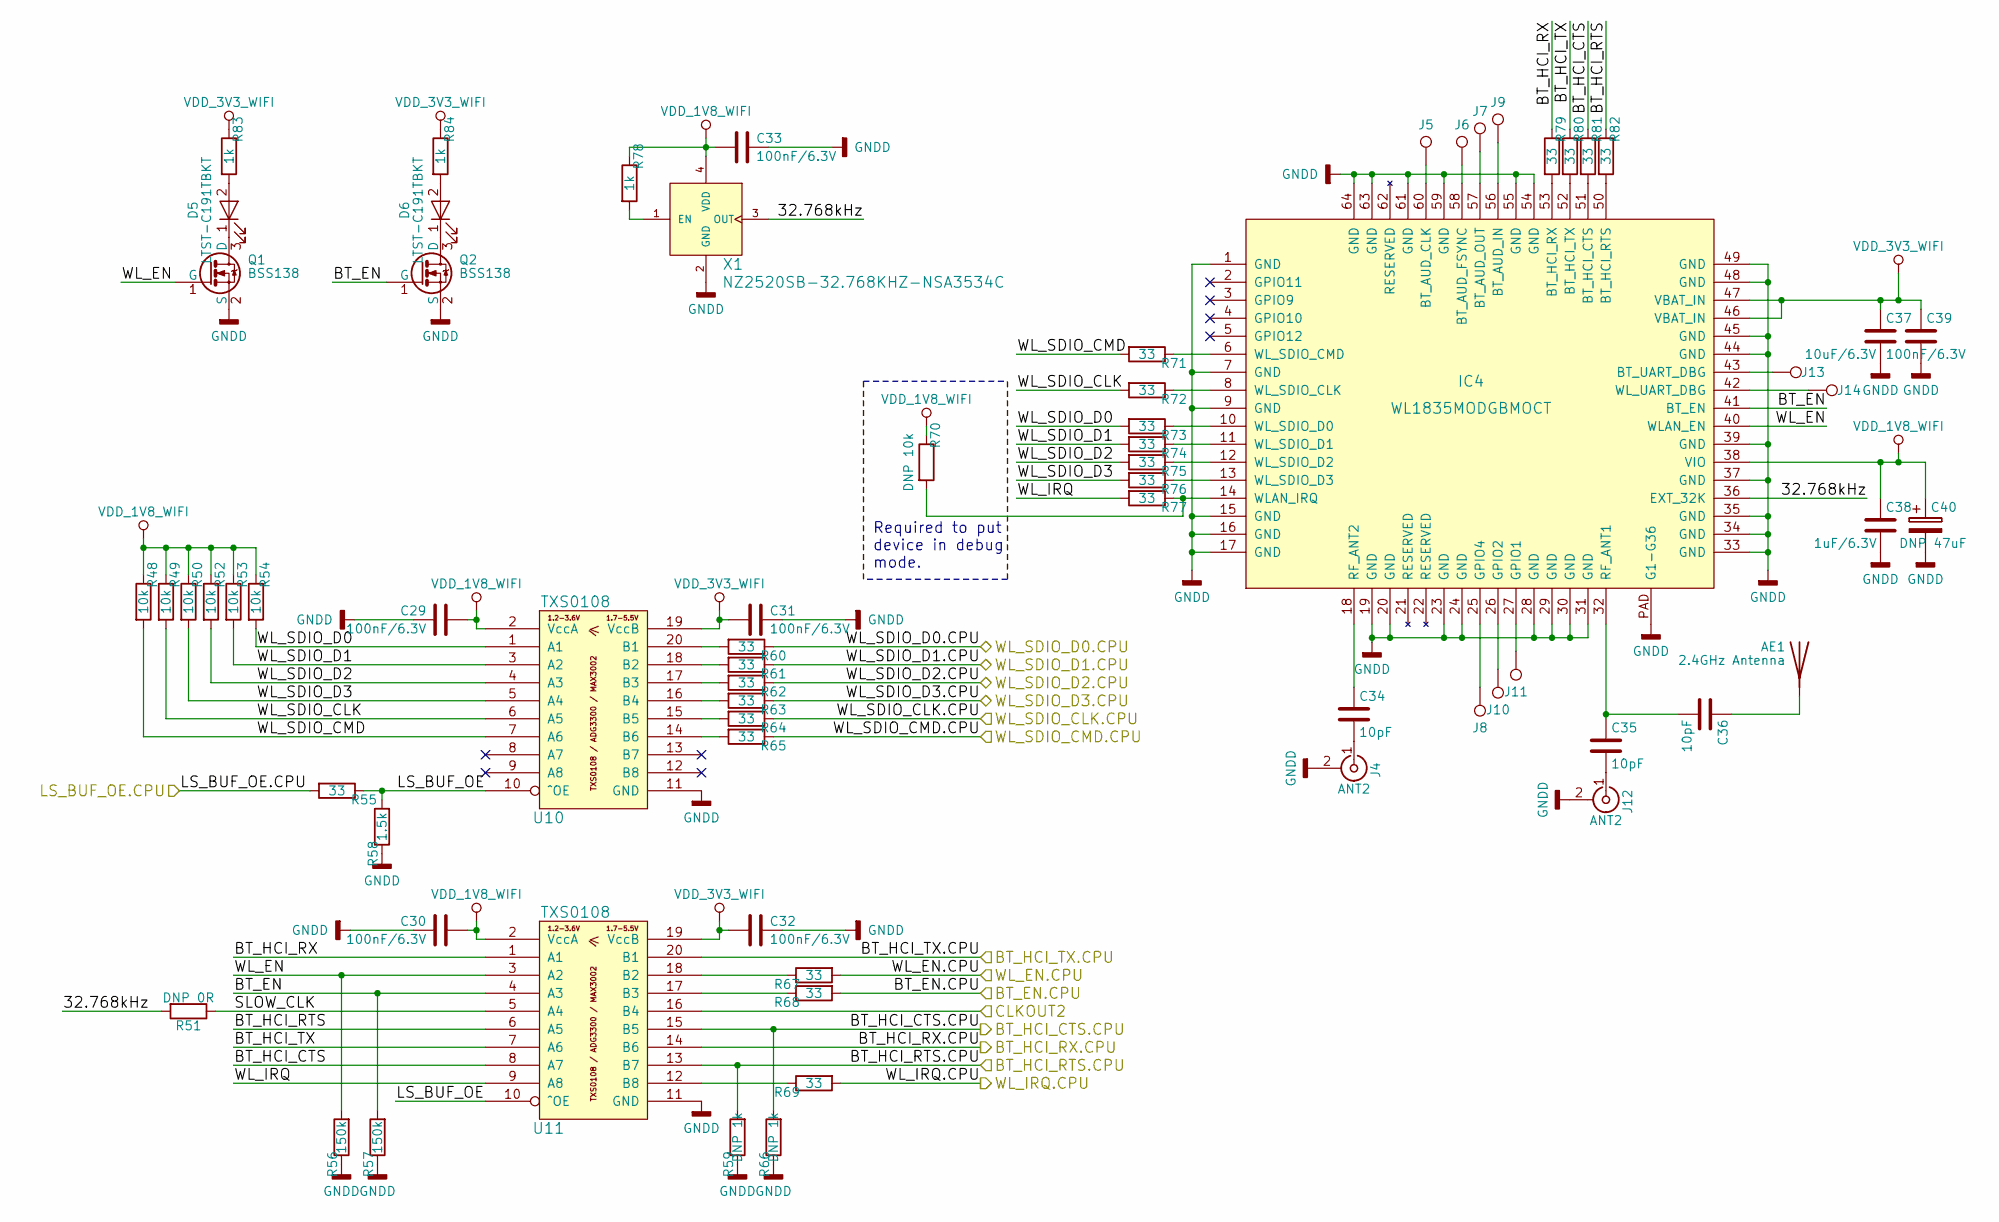
[picture p20: schematic wifi.sch, Mateboard]

Parts:
AE1: 2.4GHz Antenna; 2450AT43B100E
C29, C30, C31, C32, C33, C39: 100nF/6.3V; C_0402
C34, C35, C36: 10pF; C_0402
C37: 10uF/6.3V; C_0603
C38: 1uF/6.3V; C_0402
C40: DNP 47uF; CP_Tantalum_Case-A_EIA-3216-18_Reflow
D5, D6: LTST-C191TBKT; LED_0603
IC4: WL1835MODGBMOCT; BeagleBone_Blue-GHI-IC_MOC-100(TI)
J4, J12: ANT2; BeagleBone_Blue-GHI-CONNECTORS_U.FL-R-SMT-1
J5, J6, J7, J8, J9, J10, J11, J13, J14: TEST_1P; Measurement_Point_Round-SMD-Pad_Small
Q1, Q2: BSS138; SOT-23
R48, R49, R50, R52, R53, R54: 10k; R_0402
R51: DNP 0R; R_0402
R55, R60, R61, R62, R63, R64, R65, R67, R68, R69, R71, R72, R73, R74, R75, R76, R77, R79, R80, R81, R82: 33; R_0402
R56, R57: 150k; R_0402
R58: 1.5k; R_0402
R59, R66: DNP 1k; R_0402
R70: DNP 10k; R_0402
R78, R83, R84: 1k; R_0402
U10, U11: TXS0108; TSSOP-20_4.4x6.5mm_Pitch0.65mm
X1: NZ2520SB-32.768KHZ-NSA3534C; Crystal_SMD_2520-4pin_2.5x2.0mm

Connections:
/CLKOUT2: U11.16 (B4); also elsewhere on the board
/Wi-Fi BLE/32.768kHz: IC4.36 (EXT_32K), R51.2, X1.3 (OUT)
/Wi-Fi BLE/BT_EN: IC4.41 (BT_EN), Q2.1 (G), R57.2, U11.4 (A3)
/Wi-Fi BLE/BT_EN.CPU: R68.2; also elsewhere on the board
/Wi-Fi BLE/BT_HCI_CTS: R81.1, U11.8 (A7)
/Wi-Fi BLE/BT_HCI_CTS.CPU: R66.2, U11.15 (B5); also elsewhere on the board
/Wi-Fi BLE/BT_HCI_RTS: R82.1, U11.6 (A5)
/Wi-Fi BLE/BT_HCI_RTS.CPU: R59.2, U11.13 (B7); also elsewhere on the board
/Wi-Fi BLE/BT_HCI_RX: R79.1, U11.1 (A1)
/Wi-Fi BLE/BT_HCI_RX.CPU: U11.14 (B6); also elsewhere on the board
/Wi-Fi BLE/BT_HCI_TX: R80.1, U11.7 (A6)
/Wi-Fi BLE/BT_HCI_TX.CPU: U11.20 (B1); also elsewhere on the board
/Wi-Fi BLE/LS_BUF_OE: R55.1, R58.2, U10.10 (^OE), U11.10 (^OE)
/Wi-Fi BLE/LS_BUF_OE.CPU: R55.2; also elsewhere on the board
/Wi-Fi BLE/SLOW_CLK: R51.1, U11.5 (A4)
/Wi-Fi BLE/WL_EN: IC4.40 (WLAN_EN), Q1.1 (G), R56.2, U11.3 (A2)
/Wi-Fi BLE/WL_EN.CPU: R67.2; also elsewhere on the board
/Wi-Fi BLE/WL_IRQ: R77.2, U11.9 (A8)
/Wi-Fi BLE/WL_IRQ.CPU: R69.2; also elsewhere on the board
/Wi-Fi BLE/WL_SDIO_CLK: R49.2, R72.2, U10.6 (A5)
/Wi-Fi BLE/WL_SDIO_CLK.CPU: R64.1; also elsewhere on the board
/Wi-Fi BLE/WL_SDIO_CMD: R48.2, R71.2, U10.7 (A6)
/Wi-Fi BLE/WL_SDIO_CMD.CPU: R65.1; also elsewhere on the board
/Wi-Fi BLE/WL_SDIO_D0: R54.2, R73.2, U10.1 (A1)
/Wi-Fi BLE/WL_SDIO_D0.CPU: R60.1; also elsewhere on the board
/Wi-Fi BLE/WL_SDIO_D1: R53.2, R74.2, U10.3 (A2)
/Wi-Fi BLE/WL_SDIO_D1.CPU: R61.1; also elsewhere on the board
/Wi-Fi BLE/WL_SDIO_D2: R52.2, R75.2, U10.4 (A3)
/Wi-Fi BLE/WL_SDIO_D2.CPU: R62.1; also elsewhere on the board
/Wi-Fi BLE/WL_SDIO_D3: R50.2, R76.2, U10.5 (A4)
/Wi-Fi BLE/WL_SDIO_D3.CPU: R63.1; also elsewhere on the board
GNDD: C29.1, C30.1, C31.1, C32.1, C33.1, C37.2, C38.2, C39.2, C40.2, IC4.1 (GND), IC4.7 (GND), IC4.9 (GND), IC4.15 (GND), IC4.16 (GND), IC4.17 (GND), IC4.19 (GND), IC4.20 (GND), IC4.23 (GND), IC4.24 (GND), IC4.28 (GND), IC4.29 (GND), IC4.30 (GND), IC4.31 (GND), IC4.33 (GND), IC4.34 (GND), IC4.35 (GND), IC4.37 (GND), IC4.39 (GND), IC4.44 (GND), IC4.45 (GND), IC4.48 (GND), IC4.49 (GND), IC4.54 (GND), IC4.55 (GND), IC4.59 (GND), IC4.61 (GND), IC4.63 (GND), IC4.64 (GND), IC4.PAD (G1-G36), J4.2 (Ext), J12.2 (Ext), Q1.2 (S), Q2.2 (S), R56.1, R57.1, R58.1, R59.1, R66.1, U10.11 (GND), U11.11 (GND), X1.2 (GND); also elsewhere on the board
unnamed: AE1.1, C36.1
unnamed: C34.1, IC4.18 (RF_ANT2)
unnamed: C34.2, J4.1 (In)
unnamed: C35.1, C36.2, IC4.32 (RF_ANT1)
unnamed: C35.2, J12.1 (In)
unnamed: D5.1 (K), Q1.3 (D)
unnamed: D5.2 (A), R83.2
unnamed: D6.1 (K), Q2.3 (D)
unnamed: D6.2 (A), R84.2
unnamed: IC4.6 (WL_SDIO_CMD), R71.1
unnamed: IC4.8 (WL_SDIO_CLK), R72.1
unnamed: IC4.10 (WL_SDIO_D0), R73.1
unnamed: IC4.11 (WL_SDIO_D1), R74.1
unnamed: IC4.12 (WL_SDIO_D2), R75.1
unnamed: IC4.13 (WL_SDIO_D3), R76.1
unnamed: IC4.14 (WLAN_IRQ), R70.2, R77.1
unnamed: IC4.25 (GPIO4), J8.1
unnamed: IC4.26 (GPIO2), J10.1
unnamed: IC4.27 (GPIO1), J11.1
unnamed: IC4.42 (WL_UART_DBG), J14.1
unnamed: IC4.43 (BT_UART_DBG), J13.1
unnamed: IC4.50 (BT_HCI_RTS), R82.2
unnamed: IC4.51 (BT_HCI_CTS), R81.2
unnamed: IC4.52 (BT_HCI_TX), R80.2
unnamed: IC4.53 (BT_HCI_RX), R79.2
unnamed: IC4.56 (BT_AUD_IN), J9.1
unnamed: IC4.57 (BT_AUD_OUT), J7.1
unnamed: IC4.58 (BT_AUD_FSYNC), J6.1
unnamed: IC4.60 (BT_AUD_CLK), J5.1
unnamed: R60.2, U10.20 (B1)
unnamed: R61.2, U10.18 (B2)
unnamed: R62.2, U10.17 (B3)
unnamed: R63.2, U10.16 (B4)
unnamed: R64.2, U10.15 (B5)
unnamed: R65.2, U10.14 (B6)
unnamed: R67.1, U11.18 (B2)
unnamed: R68.1, U11.17 (B3)
unnamed: R69.1, U11.12 (B8)
unnamed: R78.2, X1.1 (EN)
VDD_1V8_WIFI: C29.2, C30.2, C33.2, C38.1, C40.1, IC4.38 (VIO), R48.1, R49.1, R50.1, R52.1, R53.1, R54.1, R70.1, R78.1, U10.2 (VccA), U11.2 (VccA), X1.4 (VDD); also elsewhere on the board
VDD_3V3_WIFI: C31.2, C32.2, C37.1, C39.1, IC4.46 (VBAT_IN), IC4.47 (VBAT_IN), R83.1, R84.1, U10.19 (VccB), U11.19 (VccB); also elsewhere on the board

Notes on the sheet:
Required to put device in debug mode.

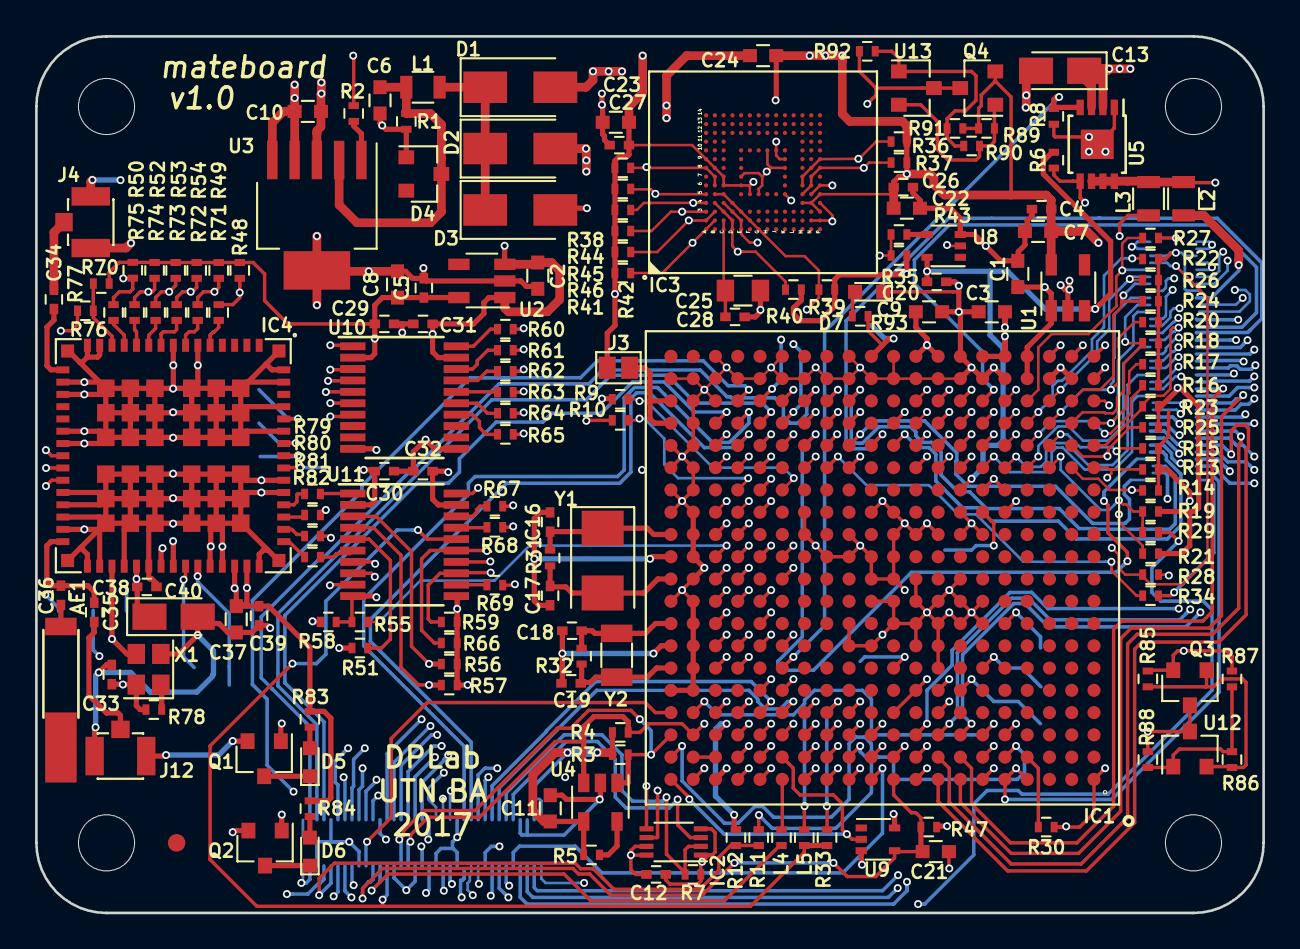
[picture p21: board mateboard.kicad_pcb from above]

Board: 6 copper layers, 70.0 x 50.0 mm, 190 parts (0 on the bottom side), 239 nets.
