pridolfi/mateboard/(commit log)

2017-02-10 power mgmnt done
    [ddr.sch, io.sch, mateboard.sch, power.sch]
2017-02-20 cpu power done
    [cpu_power.sch, io.sch, mateboard.sch, power.sch, system.sch]
2017-02-21 emmc nand and micro sd
    [cpu_power.sch, ddr.sch, mateboard.sch, mmc.sch, power.sch, system.sch, usb.sch]
2017-02-21 hierarchical sheets defined
    [cpu_power.sch, ddr.sch, io.sch, mateboard.sch, mmc.sch, power.sch, usb.sch, wifi.sch]
2017-02-23 system sheet
    [cpu_power.sch, ddr.sch, io.sch, mateboard.sch, mmc.sch, power.sch, system.sch, usb.sch]
2017-02-23 wip wifi
    [usb.sch, wifi.sch]
2017-03-01 wip wl1835 lib
    [cpu_power.sch, ddr.sch, io.sch, mateboard.sch, mmc.sch, power.sch, system.sch, usb.sch]
2017-03-02 wifi bt done
    [cpu_power.sch, ddr.sch, io.sch, mateboard.sch, mmc.sch, power.sch, system.sch, usb.sch]
2017-03-02 wifi bt leds
    [mateboard.sch, wifi.sch]
2017-03-02 id eeprom
    [io.sch, mateboard.sch, wifi.sch]
2017-03-02 gpio and boot config
    [cpu_power.sch, ddr.sch, io.sch, mateboard.sch, mmc.sch, power.sch, sysboot.sch, system.sch]
2017-03-02 wip gpio
    [io.sch, mateboard.sch, mmc.sch]
2017-03-03 gpio assignment done
    [cpu_power.sch, io.sch, mateboard.sch, mmc.sch, power.sch, sysboot.sch, system.sch, usb.sch]
2017-03-06 gpio connectors
    [mateboard.sch, mmc.sch, wifi.sch]
2017-03-08 add doc and update sch
    [mateboard.sch]
2017-03-09 annotation, wip erc
    [cpu_power.sch, ddr.sch, io.sch, mateboard.sch, mmc.sch, power.sch, sysboot.sch, system.sch]
2017-03-10 erc passed, sch first version
    [cpu_power.sch, ddr.sch, io.sch, mateboard.sch, mmc.sch, power.sch, sysboot.sch, system.sch]
2017-03-11 wip display connector
    [cpu_power.sch, ddr.sch, io.sch, mateboard.sch, mmc.sch, power.sch, sysboot.sch, system.sch]
2017-03-16 add display connector, bom generated, sch second version
    [io.sch, mateboard.csv, mateboard.sch, sysboot.sch, system.sch]
2017-03-16 wip bom
    [mateboard-bom.ods]
2017-03-18 wip bom, fix some capacitors
    [mateboard-bom.ods, system.sch]
2017-03-20 osd335x lib and kicad_pcb files
2017-03-20 autosave ignored
    [mateboard.kicad_pcb]
2017-03-21 wip sch
    [cpu_power.sch, ddr.sch, io.sch, mateboard.sch, mmc.sch, power.sch, sysboot.sch, system.sch]
2017-03-27 wip sys and power
    [cpu_power.sch, mateboard.sch, power.sch, system.sch, usb.sch, wifi.sch]
2017-03-28 only io connectors remaining
    [cpu_power.sch, mateboard.sch, power.sch, sysboot.sch, system.sch, usb.sch, wifi.sch]
2017-03-28 wip erc
    [mateboard.sch, system.sch, usb.sch, wifi.sch]
2017-03-29 erc passed
    [cpu_power.sch, mateboard.sch, power.sch, system.sch, usb.sch, wifi.sch]
2017-04-03 bom done
    [mateboard-bom.ods]
2017-04-04 wip footprint assoc
    [cpu_power.sch, mateboard-bom.ods, power.sch, system.sch, usb.sch, wifi.sch]
2017-04-05 start placing
    [mateboard-bom.ods, mateboard.kicad_pcb, mateboard.sch, wifi.sch]
2017-04-05 wip placing
    [mateboard.kicad_pcb]
2017-04-10 placing 1st iteration
    [mateboard.kicad_pcb, usb.sch]
2017-04-10 G pads of IC4 to GNDD
    [mateboard.kicad_pcb]
2017-04-11 footprint check
    [mateboard.kicad_pcb]
2017-04-12 wip routing
    [mateboard.kicad_pcb]
2017-04-19 wip routing wifi
    [mateboard.kicad_pcb, usb.sch]
2017-04-26 connector pinout rearrangement
    [mateboard.kicad_pcb, mateboard.sch, power.sch]
2017-04-27 arranging signals
    [cpu_power.sch, mateboard.kicad_pcb, mateboard.sch, power.sch, system.sch, usb.sch, wifi.sch]
2017-04-29 j1 io routing done
    [mateboard.kicad_pcb, mateboard.sch]
2017-04-29 routing j2
    [mateboard.kicad_pcb, mateboard.sch]
2017-04-29 wip j2
    [cpu_power.sch, mateboard.kicad_pcb, mateboard.sch, power.sch, system.sch, usb.sch, wifi.sch]
2017-05-02 routing done
    [cpu_power.sch, mateboard.kicad_pcb, mateboard.sch, power.sch, system.sch, usb.sch, wifi.sch]
2017-05-02 routing done, drc ok
    [mateboard.kicad_pcb]
2017-05-02 add gerber
    [mateboard-B.Mask.gbr, mateboard-B.Paste.gbr, mateboard-B.SilkS.gbr, mateboard-Bot.Cu.gbr, mateboard-Edge.Cuts.gbr, mateboard-F.Mask.gbr, mateboard-F.Paste.gbr, mateboard-F.SilkS.gbr]
2017-05-06 add clamping protection for 3v3a and 3v3b
    [cpu_power.sch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]
2017-06-21 sch updated
    [DF40C-70DP.stp, STL\STL\STL\SOT-223_5MC.stp, U.FL-R-SMT-1.stp, cpu_power.sch, mateboard.csv, mateboard.sch, power.sch, system.sch]
2017-06-23 footprints updated, add power led
    [cpu_power.sch, mateboard.kicad_pcb, power.sch, system.sch, usb.sch, wifi.sch]
2017-06-23 fixing design
    [cpu_power.sch, mateboard.kicad_pcb, mateboard.sch, power.sch, system.sch, usb.sch, wifi.sch]
2017-06-23 j1 and j2 aligned, 3d model test
    [mateboard.kicad_pcb]
2017-06-29 mateboard v1.0
    [ABS07.STEP, SOT-223_5MC.stp, User Library-153BallWFBGA.STEP, User Library-AN9520.STEP, WL18xx.STEP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]
2017-07-24 gerbers updated, bom using kicost
    [Mate Presupuesto.ods, cpu_power.sch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]
